stephen5ng/cube-pn5180/dev-boards/3C:8A:1F:77:E3:4D.jpg

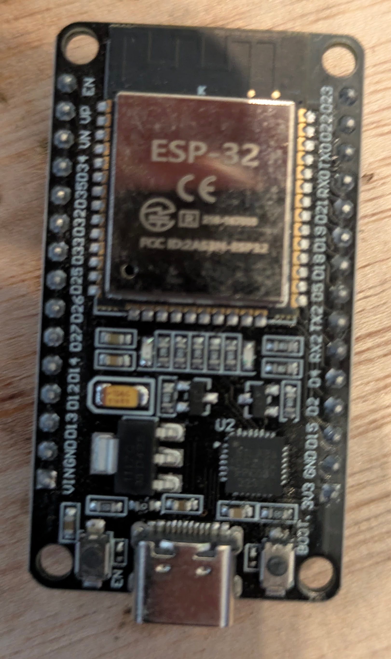
dev-boards/3C:8A:1F:77:E3:4D.jpg
