stephen5ng/cube-pn5180/dev-boards/ESP32_14-33-5C-30-29-EC_counterfeit.jpg

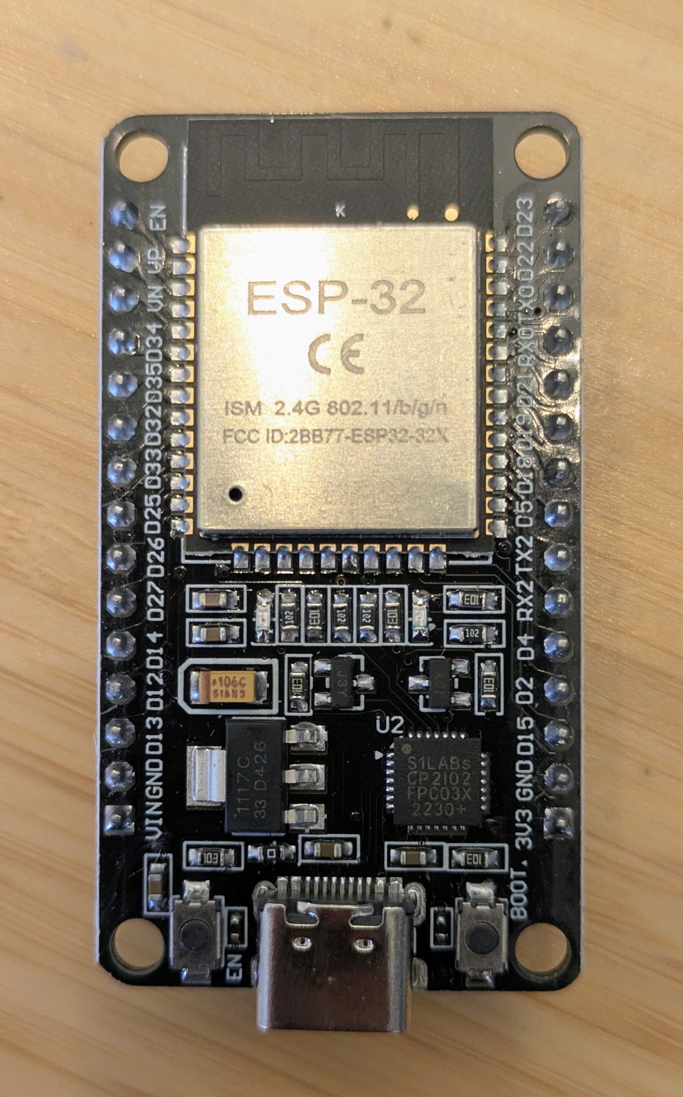
dev-boards/ESP32_14-33-5C-30-29-EC_counterfeit.jpg
