stephen5ng/cube-pn5180/docs/bad_esp32_chips.md

# Bad ESP32 Chips

Track ESP32 modules removed due to hardware defects.
MAC addresses from nearby batches may have similar issues.

| MAC | Was Cube | Issue | Date Removed |
|-----|---|---|---|
| 14:33:5C:30:25:98 | 5 | WiFi latency — persistent 500-3000ms MQTT delays, not fixed by power cycle or reboot | 2026-04-08 |
| 94:54:C5:EE:87:F0 | 5 | HUB75 display problems — severe display artifacts | 2026-04-08 |
