stephen5ng/cube-pn5180/(list of files, drawings)

Other design files:
hardware/v6/cube-esp32-c6-easyeda-sch.json
hardware/v6/cube-esp32-c6-easyeda.json
