stephen5ng/cube-pn5180/hardware/v6/kicad/cube-esp32-c6.kicad_pcb

## KiCad design hardware/v6/kicad/cube-esp32-c6.kicad_pcb (2026-03-04, last stored version)

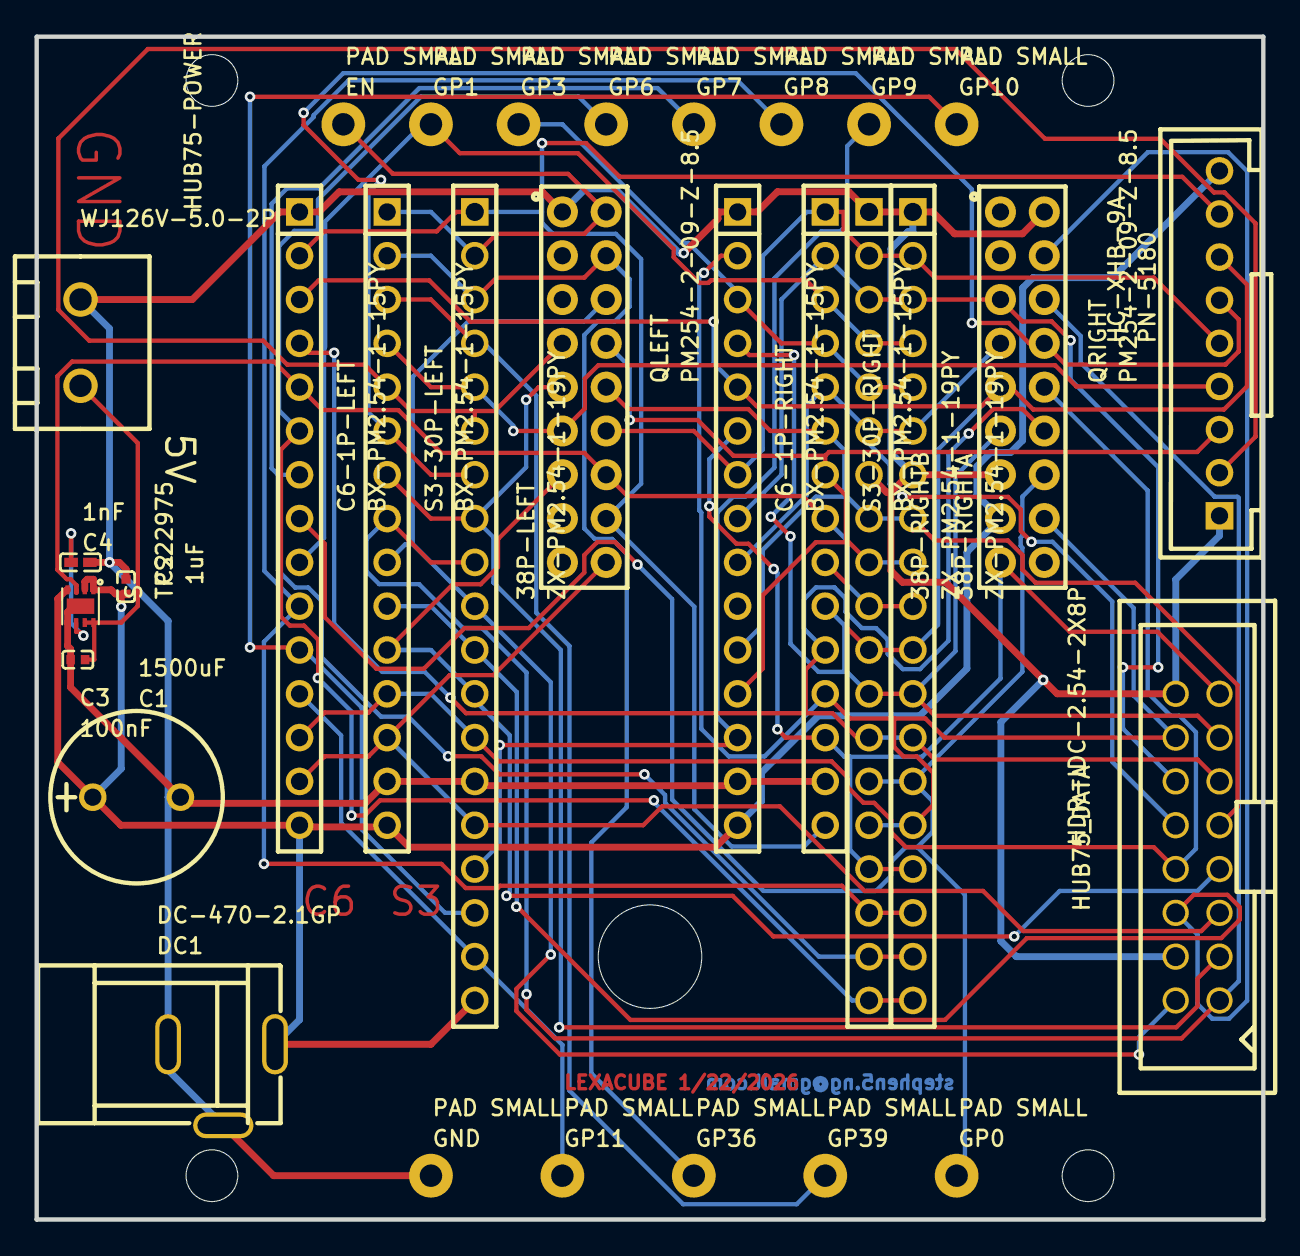
[picture p3: board cube-esp32-c6.kicad_pcb from above]

Board: 2 copper layers, 71.1 x 68.6 mm, 36 parts (0 on the bottom side), 38 nets.

Parts:
38P-LEFT, 38P-RIGHTA, 38P-RIGHTB: ZX-PM2.54-1-19PY; HDR-TH_19P-P2.54-V-F
C1: 1500uF; CAP-TH_BD10.0-P5.00-D1.0-FD
C2: 1uF; C0402
C3: 100nF; C0402
C4: 1nF; C0402
C6-1P-LEFT, C6-1P-RIGHT: BX-PM2.54-1-15PY; HDR-TH_15P-P2.54-V-F-1
DC1: DC-470-2.1GP; DC-IN-TH_DC-470-2.1GP
EN: PAD SMALL; PADPAD
GND: PAD SMALL; PADPAD
GP0, GP1, GP3, GP6, GP7, GP8, GP9, GP10, GP11, GP36, GP39: PAD SMALL; PADPAD
HUB75-POWER: WJ126V-5.0-2P; CONN-TH_WJ126V-5.0-2P
HUB75_DATA: HDR-IDC-2.54-2X8P; IDC-TH_16P-P2.54_C3406
Hole_gge5988: Hole_gge5988
Hole_gge6018: Hole_gge6018
Hole_gge6033: Hole_gge6033
Hole_gge6048: Hole_gge6048
Hole_gge95769: Hole_gge95769
PN-5180: HC-XHB-9A; CONN-TH_9P_P2.50_HCTL_HC-XHB-9A
QLEFT: PM254-2-09-Z-8.5; HDR-TH_18P-P2.54-V-F-R2-C9-S2.54
QRIGHT: PM254-2-09-Z-8.5; HDR-TH_18P-P2.54-V-F-R2-C9-S2.54
S: TPS22975; WSON-8_L2.0-W2.0-P0.50-TL-EP
S3-30P-LEFT, S3-30P-RIGHT: BX-PM2.54-1-15PY; HDR-TH_15P-P2.54-V-F-1

Connections:
3V: 38P-LEFT.1, C6-1P-LEFT.2, PN-5180.8, QLEFT.16, S3-30P-RIGHT.15
+5V: 38P-LEFT.19, C1.1, C2.2, C6-1P-LEFT.15, C6-1P-RIGHT.15, DC1.1, PN-5180.9, QRIGHT.15, S.1, S.2, S.4, S3-30P-LEFT.15
A: 38P-RIGHTA.8, 38P-RIGHTB.8, C6-1P-RIGHT.11, HUB75_DATA.9, QLEFT.10, S3-30P-RIGHT.6
B: 38P-RIGHTA.6, 38P-RIGHTB.6, C6-1P-RIGHT.9, HUB75_DATA.10, QRIGHT.7, S3-30P-RIGHT.5
B1: 38P-LEFT.8, HUB75_DATA.3, QLEFT.9, S3-30P-LEFT.7
B2: 38P-LEFT.12, HUB75_DATA.7, QLEFT.13, S3-30P-LEFT.11
BUSY: 38P-LEFT.6, PN-5180.2, QLEFT.7, S3-30P-LEFT.5
C: 38P-RIGHTA.13, 38P-RIGHTB.13, C6-1P-LEFT.4, HUB75_DATA.11, QRIGHT.12, S3-30P-RIGHT.11
CLK: 38P-RIGHTA.12, 38P-RIGHTB.12, C6-1P-RIGHT.4, HUB75_DATA.13, QRIGHT.11, S3-30P-RIGHT.10
D: 38P-RIGHTA.3, 38P-RIGHTB.3, C6-1P-RIGHT.8, HUB75_DATA.12, QRIGHT.5, S3-30P-RIGHT.2
E: 38P-LEFT.13, C6-1P-LEFT.13, HUB75_DATA.8, QRIGHT.10, S3-30P-LEFT.12
EN: 38P-LEFT.2, EN.1, QLEFT.2, S3-30P-LEFT.1
G1: 38P-LEFT.10, HUB75_DATA.2, QLEFT.6, S3-30P-LEFT.9
G2: 38P-LEFT.11, HUB75_DATA.6, QRIGHT.4, S3-30P-LEFT.10
GND: 38P-LEFT.14, 38P-RIGHTA.1, 38P-RIGHTA.7, 38P-RIGHTB.1, 38P-RIGHTB.7, C1.2, C2.1, C3.2, C4.2, C6-1P-LEFT.1, C6-1P-RIGHT.1, C6-1P-RIGHT.14, DC1.2, DC1.3, GND.1, HUB75-POWER.1, HUB75_DATA.4, HUB75_DATA.16, PN-5180.1, QLEFT.1, QRIGHT.2, QRIGHT.13, S.5, S.9, S3-30P-LEFT.14, S3-30P-RIGHT.14
GP_0: 38P-RIGHTA.14, 38P-RIGHTB.14, C6-1P-LEFT.8, GP0.1, QRIGHT.14
GP_1: 38P-RIGHTA.4, 38P-RIGHTB.4, C6-1P-LEFT.9, GP1.1, S3-30P-RIGHT.3
GP_3: 38P-RIGHTA.5, 38P-RIGHTB.5, C6-1P-RIGHT.3, GP3.1, S3-30P-RIGHT.4
GP_5: 38P-RIGHTA.10, 38P-RIGHTB.10, C6-1P-LEFT.5, QLEFT.14, S.3, S3-30P-RIGHT.8
GP_6: 38P-RIGHTA.19, 38P-RIGHTB.19, C6-1P-LEFT.6, GP6.1
GP_7: 38P-RIGHTA.18, 38P-RIGHTB.18, C6-1P-LEFT.7, GP7.1
GP_8: 38P-RIGHTA.17, 38P-RIGHTB.17, C6-1P-LEFT.10, GP8.1
GP_9: 38P-LEFT.16, C6-1P-RIGHT.13, GP9.1
GP_10: 38P-LEFT.17, C6-1P-LEFT.11, GP10.1
GP_11: 38P-LEFT.18, C6-1P-LEFT.12, GP11.1
GP_36: 38P-LEFT.3, GP36.1, QLEFT.4, S3-30P-LEFT.2
GP_39: 38P-LEFT.4, GP39.1, S3-30P-LEFT.3
LAT: 38P-RIGHTA.15, 38P-RIGHTB.15, C6-1P-RIGHT.2, HUB75_DATA.14, QRIGHT.16, S3-30P-RIGHT.12
MISO: 38P-LEFT.5, PN-5180.4, QLEFT.11, S3-30P-LEFT.4
MOSI: 38P-RIGHTA.2, 38P-RIGHTB.2, C6-1P-RIGHT.7, PN-5180.5, QLEFT.12, S3-30P-RIGHT.1
NSS: 38P-LEFT.7, PN-5180.6, QRIGHT.8, S3-30P-LEFT.6
OE: 38P-RIGHTA.16, 38P-RIGHTB.16, C6-1P-RIGHT.6, HUB75_DATA.15, QRIGHT.17, S3-30P-RIGHT.13
R1: 38P-LEFT.9, HUB75_DATA.1, QRIGHT.6, S3-30P-LEFT.8
R2: 38P-LEFT.15, C6-1P-LEFT.14, HUB75_DATA.5, QLEFT.18, S3-30P-LEFT.13
RST: 38P-RIGHTA.11, 38P-RIGHTB.11, C6-1P-LEFT.3, C6-1P-RIGHT.5, PN-5180.7, QRIGHT.9, S3-30P-RIGHT.9
SCK: 38P-RIGHTA.9, 38P-RIGHTB.9, C6-1P-RIGHT.12, PN-5180.3, QLEFT.8, S3-30P-RIGHT.7
S_6: C4.1, S.6
S_7: C3.1, HUB75-POWER.2, S.7, S.8
