stephen5ng/cube-pn5180/src/hall_presence.h

#pragma once

#include <math.h>
#include <stdint.h>

// Presence detection for the DRV5055 analog hall sensor. No Arduino dependencies, so it
// unit-tests natively.
//
// Compares against a tracked baseline rather than a fixed midpoint, because the sensor
// centre is ratiometric to +3V3 while the ESP32 ADC references its own bandgap: rail
// movement shows up directly as a reading shift and is the same order as the signal.
struct HallPresenceConfig {
  int8_t   direction;         // +1 if the presence magnet drives the reading up
  int16_t  on_delta;          // counts from baseline to assert
  int16_t  off_delta;         // counts to release
  uint8_t  fast_shift;        // IIR shift on the raw reading
  uint8_t  base_shift;        // IIR shift on the baseline
  uint16_t base_interval_ms;  // how often the baseline may adapt
};

// A baseline is only worth writing to flash when it was taken with nothing
// magnetic nearby, because an NVS seed outlives the mistake: a poisoned RTC
// value costs one wake, a poisoned seed costs every cold boot until something
// overwrites it. An id_mask of 0 is the physical proof -- no ID magnet is in
// range, so no neighbour is docked and its presence magnet cannot be skewing
// the reading, whether or not the tracker has asserted.
//
// The move threshold is what keeps this off the flash: the baseline wanders a
// count or two a second, and NVS erases a sector per write.
static constexpr int PRESENCE_BASELINE_SAVE_DELTA = 16;

inline bool shouldSavePresenceBaseline(uint8_t id_mask, bool active, int baseline,
                                       int stored) {
  if (id_mask != 0 || active) return false;
  const int move = baseline > stored ? baseline - stored : stored - baseline;
  return move > PRESENCE_BASELINE_SAVE_DELTA;
}

// delta is a field strength, which falls off as the cube of distance, so it is a
// badly misleading gauge of how close a neighbour is: the 176 -> 148 drop
// measured while re-seating slot 1 looks like losing a sixth of the signal and
// is under 6% of extra gap. These convert it to a distance, in units where 100
// is the gap at which presence latches on.
//
// Calibration-free by construction: only the ratio to on_delta matters, so no
// bench measurement of a real gap is needed. The cost is that the number is
// relative, not millimetres, and the inverse-cube law holds in the far field --
// across a gap comparable to the magnet the true exponent is smaller, so a
// distance change is somewhat larger than reported.
static constexpr int PRESENCE_DISTANCE_REFERENCE = 100;
static constexpr int PRESENCE_DISTANCE_OUT_OF_RANGE = 999;

inline int hallPresenceDistance(int delta, int on_delta) {
  if (delta < 1) return PRESENCE_DISTANCE_OUT_OF_RANGE;  // at or behind the baseline
  return (int)lroundf(PRESENCE_DISTANCE_REFERENCE *
                      cbrtf((float)on_delta / (float)delta));
}

// 0..100 for driving an animation: 0 is nothing in range, 100 is as close as a
// docked neighbour gets. Rising with proximity so brightness, size or speed can
// use it directly, and clamped at both ends so a consumer never has to know
// about the out-of-range sentinel.
//
// The endpoints are where the number stops being informative rather than where
// the thresholds sit, and both are stated in the delta counts they were
// measured in rather than in derived distance: the far end is the ADC noise
// floor, beyond which nothing is distinguishable from an idle sensor, and the
// near end is a docked reading. Presence latching and releasing both fall
// inside this span, which is deliberate -- most of the visible travel happens
// before a cube is close enough to latch.
// Measured on slot 1 on 2026-08-13, five weeks before v2.3 and its DRV5055A2
// existed -- so these, like every other delta in this file, are A4 numbers.
// (Slot 1 carries a v2.3 board now, which is the whole reason for the gain.)
// See hallGainForRev().
static constexpr int PRESENCE_CLOSENESS_NOISE_DELTA = 35;    // measured on slot 1
static constexpr int PRESENCE_CLOSENESS_DOCKED_DELTA = 127;  // measured on slot 1

// The hall board's presence sensor sets how many ADC counts a given field is
// worth, and the two revs in the fleet are not the same part:
//
//   v2.2        DRV5055A4   12.5 mV/mT   gain 1  (what every delta here is
//                                                 calibrated against)
//   v2.3, v2.4  DRV5055A2   50 mV/mT     gain 4
//
// The whole family is binary steps off A4 -- A3 25 mV/mT, A1 100 mV/mT -- so an
// integer gain covers every variant and no delta needs floating point. Both
// parts share the ratiometric VCC/2 quiescent output, so the gain changes how
// far a magnet moves the reading and not where the reading rests: the baseline
// tracker is unaffected, only the thresholds scale.
//
// Nothing can detect this at runtime. At rest the two are indistinguishable, so
// a cube has to be told; see cube/device/<mac>/hall_rev.
inline int hallGainForRev(const char* rev) {
  if (rev == nullptr) return 0;
  if (rev[0] != 'a' && rev[0] != 'A') return 0;
  if (rev[1] == '\0' || rev[2] != '\0') return 0;
  switch (rev[1]) {
    case '1': return 8;
    case '2': return 4;
    case '3': return 2;
    case '4': return 1;
    default:  return 0;   // unparseable; caller keeps its current gain
  }
}

// A gain that came back from NVS or off the wire. Anything else is corruption or
// a typo, and silently scaling the thresholds by it would be worse than
// ignoring it.
inline bool plausibleHallGain(int gain) {
  return gain == 1 || gain == 2 || gain == 4 || gain == 8;
}

// ID-magnet patterns, as measured off the physical carriers on 2026-10-25 with
// each cube read by its right-hand neighbour. The magnets sit in fixed slots in
// a printed carrier, so these patterns are a survey of the hardware, not a
// scheme the hardware was built to match -- which is why they look arbitrary.
//
// Bit i is sensor P(i+1); exactly two bits are ever valid. The decode is
// per-player because the two groups reuse patterns: player 0's cube 2 (P4+P6)
// is player 1's cube 14, and cube 3 (P3+P6) is cube 16. Cubes from different
// players never dock, so the same mask resolving to two ids is harmless -- but
// one shared table cannot express it (two `case` labels, one value), and a
// reader only ever needs the table for its own group.
inline uint8_t hallCubeIdForMaskPlayer0(uint8_t id_mask) {
  switch (id_mask & 0x3F) {
    case 0b000011: return 1;  // P1+P2
    case 0b101000: return 2;  // P4+P6
    case 0b100100: return 3;  // P3+P6
    case 0b011000: return 4;  // P4+P5
    case 0b001001: return 5;  // P1+P4
    case 0b000110: return 6;  // P2+P3
    default:       return 0;
  }
}

// Player 1, measured with the cubes ordered A through F.
inline uint8_t hallCubeIdForMaskPlayer1(uint8_t id_mask) {
  switch (id_mask & 0x3F) {
    case 0b110000: return 11;  // P5+P6
    case 0b100010: return 12;  // P2+P6
    case 0b001100: return 13;  // P3+P4
    case 0b101000: return 14;  // P4+P6
    case 0b000101: return 15;  // P1+P3
    case 0b100100: return 16;  // P3+P6
    default:       return 0;
  }
}

// Maps a 6-bit ID mask to a neighbour cube id; 0 = invalid pattern.
//
// `own_slot` is the READER's slot, which picks the table: player 0 is slots
// 1-6, player 1 is 11-16. An unresolved slot (-1) has no group and so decodes
// nothing -- a cube that does not know who it is cannot say who is beside it.
//
// No weight check: every pattern above has exactly two bits, so a mask of any
// other weight matches no case and falls through to 0 on its own. The call
// sites used to test popcount before calling, which read as a guard and was
// really a restatement of the table. A three-bit mask -- what a stray
// positioning magnet produces -- is rejected by not being in the table.
inline uint8_t hallCubeIdForMask(uint8_t id_mask, int own_slot) {
  if (own_slot >= 1 && own_slot <= 6) return hallCubeIdForMaskPlayer0(id_mask);
  if (own_slot >= 11 && own_slot <= 16) return hallCubeIdForMaskPlayer1(id_mask);
  return 0;
}

// Which side of a cube its hall board is mounted on. Player 0's boards face
// left, player 1's face right. That is a mechanical fact about the enclosures
// and it must not reach the game, so it is resolved here.
enum class HallSensorSide { None, Left, Right };

inline HallSensorSide hallSensorSideForSlot(int own_slot) {
  if (own_slot >= 1 && own_slot <= 6) return HallSensorSide::Left;
  if (own_slot >= 11 && own_slot <= 16) return HallSensorSide::Right;
  return HallSensorSide::None;
}

// What to publish on cube/right/<topic_slot>, whose payload asserts
// "<subject_slot> is immediately to the right of <topic_slot>". That is the
// server's convention: scripts/start_game.py publishes right/<A> = <B> for a
// word spelled A then B.
//
// A cube sensing on its RIGHT observes that relation directly and is its
// subject: right/<me> = <neighbour>. A cube sensing on its LEFT sees the mirror
// image -- the neighbour is to ITS left -- so the same physical edge keys on
// the NEIGHBOUR instead: right/<neighbour> = <me>. Publishing the sensor's
// point of view on the cube's own topic asserts the edge backwards, which
// reverses the whole row, and the row is the word.
//
// topic_slot 0 means there is nothing to assert. A left-side sensor with no
// neighbour is the case that matters: it has no subject and no topic of its
// own, so the caller retires whichever topic it last wrote.
struct HallEdgeAssertion {
  int topic_slot;
  int subject_slot;  // 0 publishes "-", the standing "no neighbour" value
};

inline HallEdgeAssertion hallEdgeAssertion(int own_slot, uint8_t neighbor_id) {
  switch (hallSensorSideForSlot(own_slot)) {
    case HallSensorSide::Right:
      return {own_slot, (int)neighbor_id};
    case HallSensorSide::Left:
      if (neighbor_id == 0) return {0, 0};
      return {(int)neighbor_id, own_slot};
    case HallSensorSide::None:
    default:
      return {0, 0};
  }
}

// What a cube owes the cube/right topics when it (re)connects. Every record
// there is retained, so a stale one outlives the cube that wrote it and the
// game applies it without consulting sensor_mode -- a ghost edge, and a ghost
// word around it.
//
// Who may clear what follows from who is the SUBJECT. A right-facing cube is
// the subject of its own topic and clears it. A left-facing cube is the subject
// of its NEIGHBOUR's topic: clearing its own would delete a live edge written
// by the cube to its right, which republishes only on change, so it must not
// touch it. What it can do is retire records that name IT, because it can be to
// the right of exactly one cube.
//
// The left-facing case does NOT depend on the sensor mode, and that is the
// whole point. A cube replugged with an NFC reader stops writing cube/right
// entirely, so its last hall-era assertion -- sitting on its old neighbour's
// topic -- is exactly the record nothing else will ever overwrite.
enum class HallEdgeCleanup {
  None,              // no slot or no group: nothing to assert, nothing to retire
  ClearOwnStanding,  // own subject, hall board fitted: the standing "no neighbour"
  ClearOwnRetire,    // own subject, no hall board: delete the record outright
  WatchSelfClaims,   // not own subject: retire records naming this cube
};

inline HallEdgeCleanup hallEdgeCleanupOnConnect(int own_slot,
                                                bool sensing_magnets) {
  switch (hallSensorSideForSlot(own_slot)) {
    case HallSensorSide::Right:
      return sensing_magnets ? HallEdgeCleanup::ClearOwnStanding
                             : HallEdgeCleanup::ClearOwnRetire;
    case HallSensorSide::Left:
      return HallEdgeCleanup::WatchSelfClaims;
    case HallSensorSide::None:
    default:
      return HallEdgeCleanup::None;
  }
}

// What a hall_rev message has to do, decided from the gain it names, the gain
// NVS holds (0 if nothing is stored) and the gain the firmware is running.
//
// The distinction that matters is Persist. A cube whose build default already
// equals the named gain needs no reboot, but it does need the write: the
// default is a property of the carrier the firmware was compiled for, not of
// the daughterboard someone plugged in, so leaving NVS empty means a reflash to
// a carrier with a different default silently reverts the board's real gain.
// Storing it is what makes the setting outlive the build.
enum class HallRevAction {
  Unparseable,      // not a rev name; keep the current gain
  AlreadyApplied,   // running and stored both agree; a retained message lands here
  Persist,          // running gain is right, NVS does not say so yet
  PersistAndApply,  // running gain is wrong: store it, then rebuild the copies
};

inline HallRevAction hallRevAction(const char* rev, int stored, int running) {
  const int gain = hallGainForRev(rev);
  if (gain == 0) return HallRevAction::Unparseable;
  if (gain != running) return HallRevAction::PersistAndApply;
  if (gain != stored) return HallRevAction::Persist;
  return HallRevAction::AlreadyApplied;
}

inline int hallPresenceCloseness(int delta, int on_delta, int gain = 1) {
  const int far = hallPresenceDistance(PRESENCE_CLOSENESS_NOISE_DELTA * gain, on_delta);
  const int near_by = hallPresenceDistance(PRESENCE_CLOSENESS_DOCKED_DELTA * gain, on_delta);
  const int distance = hallPresenceDistance(delta, on_delta);
  if (distance >= far) return 0;
  if (distance <= near_by) return 100;
  return 100 * (far - distance) / (far - near_by);
}

// Whether a decoded neighbour ID may be believed, given the ID already seated during
// this presence latch (0 if none yet).
//
// A cube offset against its neighbour shows the ID sensors a real, stable pattern that
// belongs to another cube: slid one column, cube 11's P5+P6 magnets sit over P4+P5,
// which is cube 4, and a one-row offset turns 14 into 15. At Maker Faire 2026-09, 94
// of 105 out-of-set IDs were exactly that "4". Presence does not stop it: the
// hysteresis that keeps a docked cube latched down to off_delta keeps it latched
// through the slide too.
//
// So a *change* to a different ID is only believed from a neighbour that reads docked,
// while everything else passes as before:
//  - no ID, so that "no neighbour" is never held back;
//  - the seated ID coming back after a dropout, so a loosely seated cube that
//    glitches is not stranded at "no neighbour" until someone pushes it in;
//  - the first ID of a latch, because latching already required on_delta.
// Swaps within one latch are rare: 5 direct ID-to-ID changes against 6709 re-links
// through "no neighbour" over the same weekend.
inline uint8_t gateHallNeighborChange(uint8_t id, uint8_t seated_id, int delta,
                                      int docked_delta) {
  if (id == 0 || seated_id == 0 || id == seated_id) return id;
  return delta >= docked_delta ? id : 0;
}

// The neighbour ID a hall cube settles on, one decoded sample at a time.
//
// A dock or undock is reported after debounce_reads identical samples. A change
// from the seated cube to a different one waits settle_reads instead, because
// the strength check reads the tracker's filtered delta, and that lags a slide by
// about 2^fast_shift samples: a cube slid off its neighbour still reads docked
// for the first few milliseconds, long enough for a plain debounce to report the
// alias. settle_reads has to span several of those time constants.
struct HallNeighborDebounce {
  HallNeighborDebounce(uint16_t debounce_reads, uint16_t settle_reads, int docked_delta)
      : debounce_reads(debounce_reads), settle_reads(settle_reads),
        docked_delta(docked_delta) {}

  uint16_t debounce_reads;
  uint16_t settle_reads;
  int docked_delta;
  uint8_t candidate = 0;
  uint16_t count = 0;
  uint8_t seated = 0;  // last ID reported during this presence latch

  // True once `candidate` has held long enough to be reported.
  bool update(uint8_t decoded, bool presence_active, int delta) {
    if (!presence_active) seated = 0;
    const uint8_t id = gateHallNeighborChange(decoded, seated, delta, docked_delta);
    if (id == candidate) {
      if (count < UINT16_MAX) count++;
    } else {
      candidate = id;
      count = 1;
    }
    const bool change = candidate != 0 && seated != 0 && candidate != seated;
    return count >= (change ? settle_reads : debounce_reads);
  }

  // Call once `candidate` has actually been reported.
  void reported() {
    if (candidate != 0) seated = candidate;
  }
};

// The shared-edge animation is an approach hint, not a second representation of
// a confirmed neighbour. A real dock can settle below the calibrated 100% point,
// so the presence latch, rather than closeness alone, ends the preview.
inline bool shouldPreviewHallCandidate(int proximity, bool presence_active) {
  return !presence_active && proximity > 0 && proximity < 100;
}

// Where each participant's prospective neighbour sits, for the border preview.
//
// The payload is a FACT about the topology -- "my neighbour is on my west/east"
// -- not an instruction about which side to draw. That distinction is the whole
// bug history of this protocol: the preview renders two different shapes from
// it, on OPPOSITE sides, so no single "draw here" value can serve both.
//
//   free endpoint      drawEndPath caps the end AWAY from the neighbour
//   already in a chain drawPreviewSideErasing animates the shared edge,
//                      which is ON the neighbour's side
//
// previewDrawsLeftSide() turns this fact into the side to draw. Sending a side
// directly got the free-end case right and the in-chain case backwards, or the
// reverse, depending on which way round it was sent.
//
// Which side the neighbour is on follows from where the board faces: a cube
// sensing leftward has found it on its left, and is itself on its neighbour's
// right. Same mechanical fact hallEdgeAssertion resolves.
struct HallPreviewNeighbourSides {
  const char* mine;       // "" when this cube has no group and must not publish
  const char* candidate;
};

inline HallPreviewNeighbourSides hallPreviewNeighbourSides(int own_slot) {
  switch (hallSensorSideForSlot(own_slot)) {
    // I sense leftward: my neighbour is west of me, and I am east of it.
    case HallSensorSide::Left:   return {"W", "E"};
    case HallSensorSide::Right:  return {"E", "W"};
    case HallSensorSide::None:
    default:                     return {"", ""};
  }
}

// Which side the preview draws on, given where the neighbour is and whether
// this cube already has a settled vertical edge. The two topologies want
// opposite sides, which is why this is a function rather than the payload.
inline bool previewDrawsLeftSide(bool neighbour_on_left, bool has_confirmed_edge) {
  return has_confirmed_edge ? neighbour_on_left   // the shared edge, on its side
                            : !neighbour_on_left; // the free end, away from it
}

class HallPresenceTracker {
 public:
  // saved_baseline carries a baseline across a wake. Priming from the first sample
  // is blind to a magnet that is already there: the magnet gets subtracted into the
  // baseline and the neighbour is never seen. 0 means nothing was saved -- a cold
  // boot re-initialises RTC memory -- and the first sample primes as before.
  void begin(const HallPresenceConfig& cfg, int saved_baseline = 0) {
    cfg_ = cfg;
    primed_ = false;
    settle_started_ = false;
    active_ = false;
    delta_ = 0;
    base_primed_ = saved_baseline > 0;
    // Set either way. Leaving the old value in place would let baseline() keep
    // reporting a reference that begin() has just discarded, and anything that
    // copies it out -- the RTC cache, the diagnostics -- would carry it forward.
    base_ = (int32_t)(base_primed_ ? saved_baseline : 0) << cfg_.base_shift;
  }

  // id_mask is what the ID sensors read: non-zero means a neighbour is physically
  // there. Those sensors are digital and independent of this reading, so they can
  // say so while the analog signal is still below the trip point -- which is the
  // whole range the baseline must not adapt through.
  bool update(int raw, uint32_t now_ms, uint8_t id_mask) {
    if (!primed_) {
      fast_ = (int32_t)raw << cfg_.fast_shift;
      last_base_ms_ = now_ms;
      primed_ = true;
    } else {
      fast_ += raw - (fast_ >> cfg_.fast_shift);
    }

    const int f = (int)(fast_ >> cfg_.fast_shift);

    // Priming from a sample taken with a neighbour present subtracts the magnet
    // into the baseline and it is never seen again. Cubes are powered up in
    // whatever arrangement they were left in, so that is a coin flip on every
    // cold boot; wait for a clean sample instead. Until one arrives there is no
    // reference, and nothing can be reported from it.
    if (!base_primed_) {
      if (id_mask != 0) {
        settle_started_ = false;
        delta_ = 0;
        active_ = false;
        return false;
      }
      // A cold boot reaches here before the sensor output has settled. Slot 16
      // primed from a first sample of 1702 against a true idle near 1850, latched
      // on the difference, and had persisted the bad value to NVS before the
      // activation closed the save gate -- so a power cycle restored it.
      if (!settle_started_) {
        settle_started_ = true;
        settle_start_ms_ = now_ms;
        // The fast filter carries whatever it tracked through the blind period,
        // which may include a magnet that has since gone.
        fast_ = (int32_t)raw << cfg_.fast_shift;
      }
      if ((uint32_t)(now_ms - settle_start_ms_) < PRIME_SETTLE_MS) {
        delta_ = 0;
        active_ = false;
        return false;
      }
      // From the filtered value rather than this one sample: it has tracked only
      // magnet-free samples since settling began, so it is the same reading with
      // the noise taken out.
      base_ = (int32_t)f << cfg_.base_shift;
      base_primed_ = true;
      last_base_ms_ = now_ms;
      delta_ = 0;
      active_ = false;
      return false;
    }

    delta_ = cfg_.direction * (f - baseline());

    if (!active_) {
      if (delta_ >= cfg_.on_delta) active_ = true;
    } else {
      if (delta_ < cfg_.off_delta) active_ = false;
    }

    // Frozen while a neighbour is there, latched or not: otherwise the baseline
    // creeps up to the magnet and the cube forgets the neighbour is there.
    //
    // Frozen through a wrong-pole excursion too. active_ only latches upwards,
    // so a magnet presented the wrong way round leaves it false and the
    // baseline used to adapt down through the excursion. When the magnet left,
    // the restored idle reading stood on_delta clear of that poisoned
    // reference and latched with no neighbour there -- seen on cube 13, which
    // walked 1893 -> 1793 under a hand-waved magnet and then sat active at
    // delta +99, and on cube 1 after a bench flash. Anything at latch strength
    // is signal in either direction; only drift-sized moves are drift.
    // Tested on the raw sample as well as the filtered one. The fast filter
    // lags a step by design, so going by delta_ alone lets the baseline take a
    // nibble out of the excursion while the reading is still crossing the
    // drift-sized band on its way down. The raw value is the evidence; at
    // on_delta against +/-13 counts of ADC noise, one sample is enough.
    const bool excursion = delta_ <= -cfg_.on_delta ||
                           cfg_.direction * (raw - baseline()) <= -cfg_.on_delta;
    if (id_mask == 0 && !active_ && !excursion &&
        (uint32_t)(now_ms - last_base_ms_) >= cfg_.base_interval_ms) {
      base_ += f - (base_ >> cfg_.base_shift);
      last_base_ms_ = now_ms;
    }
    return active_;
  }

  bool active()   const { return active_; }
  // False until a sample arrived with no neighbour to prime from. While it is
  // false nothing is reported, which from outside looks the same as an absent
  // neighbour -- the diagnostics publish it so the two can be told apart.
  bool primed()   const { return base_primed_; }
  int  baseline() const { return (int)(base_ >> cfg_.base_shift); }
  int  filtered() const { return (int)(fast_ >> cfg_.fast_shift); }
  int  delta()    const { return delta_; }  // signed by direction; proximity measure
  // The latch threshold this tracker is actually running, which is a copy taken
  // in begin(). Reported in the diagnostics rather than recomputing it from the
  // configured gain: if the two ever disagree, the bug is exactly that the
  // tracker was not rebuilt, and a diagnostic that recomputed would hide it.
  int  onDelta()  const { return cfg_.on_delta; }

 private:
  HallPresenceConfig cfg_ {};
  int32_t  fast_ = 0;
  int32_t  base_ = 0;
  uint32_t last_base_ms_ = 0;
  int      delta_ = 0;
  bool     active_ = false;
  // How long the reading must be magnet-free before it is taken as the reference.
  static const uint32_t PRIME_SETTLE_MS = 500;
  bool     settle_started_ = false;
  uint32_t settle_start_ms_ = 0;
  bool     primed_ = false;
  bool     base_primed_ = false;
};
