stephen5ng/cube-pn5180/src/genfont.h

// Created by https://oleddisplay.squix.ch/ Consider a donation
// In case of problems make sure that you are using the font file with the correct version!
const uint8_t Roboto_Mono_Bold_78Bitmaps[] PROGMEM = {

	// Bitmap Data:
	0x00, // ' '
	0x7F,0xF3,0xFF,0x9F,0xFC,0xFF,0xE7,0xFF,0x3F,0xF9,0xFF,0xCF,0xFC,0x7F,0xE3,0xFF,0x1F,0xF8,0xFF,0xC7,0xFE,0x3F,0xF1,0xFF,0x8F,0xFC,0x7F,0xE3,0xFF,0x1F,0xF8,0xFF,0xC7,0xFE,0x3F,0xF1,0xFF,0x8F,0xFC,0x7F,0xE3,0xFF,0x1F,0xF8,0xFF,0xC7,0xFE,0x3F,0xF1,0xFF,0x8F,0xFC,0x7F,0xE3,0xFF,0x1F,0xF8,0xFF,0xC0,0x00,0x00,0x00,0x00,0x00,0x00,0x00,0x00,0x00,0x00,0x00,0x00,0x01,0xF8,0x1F,0xE1,0xFF,0x9F,0xFE,0xFF,0xF7,0xFF,0xBF,0xFD,0xFF,0xEF,0xFF,0x3F,0xF0,0xFF,0x03,0xF0, // '!'
	0xFF,0x01,0xFE,0xFF,0x01,0xFE,0xFF,0x01,0xFE,0xFF,0x01,0xFE,0xFF,0x01,0xFE,0xFE,0x01,0xFE,0xFE,0x01,0xFE,0xFE,0x01,0xFE,0xFE,0x01,0xFE,0xFE,0x01,0xFE,0xFE,0x01,0xFE,0xFE,0x01,0xFE,0xFE,0x01,0xFE,0xFE,0x01,0xFE,0xFE,0x01,0xFE,0xFE,0x01,0xFC,0xFE,0x01,0xFC,0xFE,0x01,0xFC,0xFE,0x01,0xFC,0xFC,0x01,0xFC, // '"'
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
	  {  7715,  38,  55,  48,    6,  -55 }, // 'E'
	  {  7977,  38,  55,  48,    6,  -55 }, // 'F'
	  {  8239,  41,  57,  48,    3,  -56 }, // 'G'
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
};
const GFXfont Roboto_Mono_Bold_78 PROGMEM = {
(uint8_t  *)Roboto_Mono_Bold_78Bitmaps,(GFXglyph *)Roboto_Mono_Bold_78Glyphs,0x20, 0x7E, 92};
