stephen5ng/cube-pn5180/src/cube_utilities.cpp

#include "cube_utilities.h"
#include <ctype.h>
#include <stdlib.h>

#ifdef NATIVE_TESTING
// Test MAC table - stable values that never change
// Hardware replacements should NOT require test updates
const CubeMacEntry CUBE_MAC_TABLE[] = {
  {"AA:AA:AA:AA:AA:AA", RGB_ORDER_BGR, 21},
  {"BB:BB:BB:BB:BB:BB", RGB_ORDER_BGR, 22},
  {"CC:CC:CC:CC:CC:CC", RGB_ORDER_BGR, 23},
  {"DD:DD:DD:DD:DD:DD", RGB_ORDER_BGR, 24},
  {"EE:EE:EE:EE:EE:EE", RGB_ORDER_BGR, 25},
  {"FF:FF:FF:FF:FF:FF", RGB_ORDER_BGR, 26},
  {"01:01:01:01:01:01", RGB_ORDER_RGB, 31},
  {"02:02:02:02:02:02", RGB_ORDER_RGB, 32},
  {"03:03:03:03:03:03", RGB_ORDER_RGB, 33},
  {"04:04:04:04:04:04", RGB_ORDER_RGB, 34},
  {"05:05:05:05:05:05", RGB_ORDER_RGB, 35},
  {"06:06:06:06:06:06", RGB_ORDER_RGB, 36},
  {"A1:A1:A1:A1:A1:A1", RGB_ORDER_RGB, 41},
};
#else
// Production MAC addresses - actual hardware
const CubeMacEntry CUBE_MAC_TABLE[] = {
  {"CC:DB:A7:9F:C2:84", RGB_ORDER_BGR, 21},  // 30-pin
  {"3C:8A:1F:77:DF:8C", RGB_ORDER_BGR, 22},  // 30-pin
  {"8C:4F:00:37:7C:DC", RGB_ORDER_BGR, 23},  // 30-pin
  {"CC:DB:A7:9B:5D:9C", RGB_ORDER_BGR, 24},  // 30-pin (moved from cube 11)
  {"04:83:08:59:76:98", RGB_ORDER_BGR, 25},
  {"EC:E3:34:79:8A:BC", RGB_ORDER_BGR, 26},  // 30-pin
  {"EC:E3:34:79:9D:2C", RGB_ORDER_RGB, 31},
  {"20:50:0D:1A:04:AC", RGB_ORDER_RGB, 32},  // 30-pin
  {"20:50:0D:30:95:48", RGB_ORDER_RGB, 33},
  {"94:54:C5:EE:89:4C", RGB_ORDER_RGB, 34},  // 30-pin
  {"20:50:0D:19:FB:C8", RGB_ORDER_RGB, 35},
  {"D8:BC:38:F9:39:30", RGB_ORDER_RGB, 36},  // 30-pin
  {"80:F3:DA:54:53:B8", RGB_ORDER_BGR, 41},
  {"B4:BF:E9:60:C0:68", RGB_ORDER_RGB, 42},
  {"5C:01:3B:64:E2:84", RGB_ORDER_RGB, 43},  // spare
  {"D4:8A:FC:9F:B0:C0", RGB_ORDER_BGR, 44},
  {"D8:BC:38:E5:A8:38", RGB_ORDER_RGB, 45},
  {"5C:01:3B:4A:87:4C", RGB_ORDER_RGB, 46},
  {"8C:4F:00:36:7A:88", RGB_ORDER_BGR, 47},  // spare
  {"5C:01:3B:65:F2:74", RGB_ORDER_RGB, 48},
  {"20:50:0D:0A:9F:A8", RGB_ORDER_RGB, 49},  // spare
};
#endif
const int NUM_CUBE_MAC_ENTRIES = sizeof(CUBE_MAC_TABLE) / sizeof(CUBE_MAC_TABLE[0]);

// MQTT Topic Prefixes
const char* MQTT_TOPIC_PREFIX_CUBE = "cube/";
const char* MQTT_TOPIC_PREFIX_ECHO = "echo";
const char* MQTT_TOPIC_PREFIX_VERSION = "version";

const CubeMacEntry* findCubeEntry(const char *mac_address) {
  for (int i = 0; i < NUM_CUBE_MAC_ENTRIES; i++) {
    if (strcmp(mac_address, CUBE_MAC_TABLE[i].mac) == 0) {
      return &CUBE_MAC_TABLE[i];
    }
  }
  return nullptr;
}

int findCubeIpOctet(const char *mac_address) {
  const CubeMacEntry* entry = findCubeEntry(mac_address);
  return entry ? entry->ip_octet : -1;
}

static const char* findJsonValue(const char* json, const char* key) {
  char pattern[24];
  snprintf(pattern, sizeof(pattern), "\"%s\"", key);
  const char* found = strstr(json, pattern);
  if (found == nullptr) {
    return nullptr;
  }
  const char* colon = strchr(found + strlen(pattern), ':');
  if (colon == nullptr) {
    return nullptr;
  }
  const char* value = colon + 1;
  while (isspace(static_cast<unsigned char>(*value))) {
    ++value;
  }
  return value;
}

static bool readJsonInt(const char* json, const char* key, long* out) {
  const char* value = findJsonValue(json, key);
  if (value == nullptr || *value < '0' || *value > '9') {
    return false;
  }
  char* end = nullptr;
  *out = strtol(value, &end, 10);
  while (isspace(static_cast<unsigned char>(*end))) {
    ++end;
  }
  return *end == ',' || *end == '}';
}

AssignmentParseResult parseAssignmentRecord(const char* json, CubeAssignment* out) {
  out->generation = 0;
  out->slot = -1;

  if (json == nullptr || json[0] == '\0') {
    return ASSIGNMENT_MISSING;
  }

  long protocol = 0;
  if (!readJsonInt(json, "protocol", &protocol) || protocol != 1) {
    return ASSIGNMENT_MALFORMED;
  }

  long generation = 0;
  if (!readJsonInt(json, "generation", &generation)) {
    return ASSIGNMENT_MALFORMED;
  }
  out->generation = static_cast<uint32_t>(generation);

  const char* slot_value = findJsonValue(json, "slot");
  if (slot_value == nullptr) {
    return ASSIGNMENT_MALFORMED;
  }
  if (strncmp(slot_value, "null", 4) == 0 &&
      (slot_value[4] == ',' || slot_value[4] == '}' ||
       isspace(static_cast<unsigned char>(slot_value[4])))) {
    return ASSIGNMENT_UNASSIGNED;
  }

  long slot = 0;
  if (!readJsonInt(json, "slot", &slot) || slot < 1 || slot > 16) {
    return ASSIGNMENT_MALFORMED;
  }
  out->slot = static_cast<int>(slot);
  return ASSIGNMENT_OK;
}

bool assignmentRecordIsActionable(AssignmentParseResult result) {
  return result == ASSIGNMENT_OK || result == ASSIGNMENT_UNASSIGNED;
}

int resolveAssignedSlot(AssignmentParseResult result, int record_slot,
                        bool authority_latched, int fallback_slot) {
  switch (result) {
    case ASSIGNMENT_OK:
      return record_slot;
    case ASSIGNMENT_UNASSIGNED:
      return -1;
    default:
      return authority_latched ? -1 : fallback_slot;
  }
}

void formatBootIdentity(char* out, size_t out_size, int slot, int ip_octet) {
  if (slot > 0) {
    snprintf(out, out_size, "c%d ip%d", slot, ip_octet);
  } else {
    snprintf(out, out_size, "c? ip%d", ip_octet);
  }
}

WakeAction resolveWakeAction(bool wifi_connected, bool mqtt_connected,
                             bool device_requests_sleep) {
  if (!wifi_connected || !mqtt_connected) return WAKE_ACTION_STAY_ASLEEP;
  return device_requests_sleep ? WAKE_ACTION_STAY_ASLEEP : WAKE_ACTION_WAKE_FULL;
}

void runWakeCheckIn(WakeReason wake_reason, WakeCheckInPorts& ports) {
  // Someone deciding to use the cube: the button, or a cold boot, which on the
  // battery board is unplugging USB-C -- the morning routine, and the way a
  // cube backed off for hours (checkInIntervalS) is brought back. A jostled
  // battery contact also cold-boots, and costs one ten-minute awake spell.
  if (wake_reason == WAKE_REASON_BUTTON || wake_reason == WAKE_REASON_POWER_ON) {
    ports.stayAwake();
    return;
  }

  // Any other reset -- brownout, watchdog, crash -- reads the sleep flag just
  // as a timer wake does. It is not someone deciding to use the cube, so a
  // stored cube that glitches goes back to sleep instead of burning ten
  // minutes of battery and making the next glitch likelier.
  const bool is_reset = (wake_reason == WAKE_REASON_OTHER);

  bool wifi = ports.awaitWifi();
  bool mqtt = wifi && ports.connectMqtt();
  ports.recordReachable(mqtt);
  if (!mqtt) {
    // The two wakes disagree about what silence means. A timer wake was
    // already asleep, so leaving it there costs nothing. A reset has no such
    // prior: sleeping because the broker happened to be unreachable would make
    // a working cube look dead to whoever is standing at the cabinet.
    if (is_reset) ports.stayAwake(); else ports.enterSleep();
    return;
  }

  bool sleep_requested = false;
  if (!ports.readSleepFlag(&sleep_requested)) {
    // Unconfirmed is not "no flag". Treating it as one is how a cube that
    // merely had a slow link cleared its own sleep flag and stayed awake for
    // ten minutes -- and a weak battery, which causes the slow link, is
    // exactly the cube that can least afford it.
    if (is_reset) ports.stayAwake(); else ports.enterSleep();
    return;
  }
  WakeAction action = resolveWakeAction(wifi, mqtt, sleep_requested);
  if (action == WAKE_ACTION_STAY_ASLEEP) { ports.enterSleep(); return; }
  ports.clearSleepFlag();
  ports.stayAwake();
}

uint32_t checkInIntervalS(uint32_t idle_s, uint32_t base_s,
                          uint8_t unreachable_checkins, uint32_t give_up_s) {
  if (idle_s >= give_up_s) return 0;
  if (base_s >= give_up_s) return base_s;
  uint32_t interval_s = base_s;
  for (uint8_t i = 0; i < unreachable_checkins && interval_s < give_up_s; i++) {
    interval_s *= 2;
  }
  // Never sleep past the point of giving up. A doubled interval can be shorter
  // than give_up_s and still land beyond it once idle_s is added, which would
  // have a cube on its ninth failed check-in wake at 2 h 50 min to apply a
  // 90 min rule.
  const uint32_t remaining_s = give_up_s - idle_s;
  return interval_s < remaining_s ? interval_s : remaining_s;
}

bool batteryLowEndsWake(WakeReason wake_reason, bool battery_low) {
  if (!battery_low) return false;
  return wake_reason == WAKE_REASON_TIMER || wake_reason == WAKE_REASON_OTHER;
}

bool updateBatteryLowLatch(uint32_t cell_mv, bool latched, uint8_t* low_run,
                           BatteryReading reading) {
  if (cell_mv < BATTERY_SENSE_FLOOR_MV) return latched;
  if (latched) {
    if (reading == BATTERY_READING_UNLOADED) return true;
    if (cell_mv < BATTERY_LOW_CLEAR_MV) return true;
    *low_run = 0;
    return false;
  }
  if (cell_mv >= BATTERY_LOW_MV) {
    *low_run = 0;
    return false;
  }
  if (*low_run < BATTERY_LOW_CONFIRM_READS) (*low_run)++;
  return *low_run >= BATTERY_LOW_CONFIRM_READS;
}

void convertNfcIdToHexString(uint8_t* nfc_id, int id_length, char* hex_buffer) {
  for (int i = 0; i < id_length; i++) {
    snprintf(hex_buffer + (i * 2), 3, "%02X", nfc_id[i]);
  }
  hex_buffer[id_length * 2] = '\0';
}

NfcObservationAction decideNfcObservation(bool read_ok, bool no_card,
                                          const char* tag_hex,
                                          const char* last_published) {
  if (read_ok) {
    if (tag_hex == nullptr) {
      return NFC_OBS_NONE;
    }
    return strcmp(tag_hex, last_published) == 0 ? NFC_OBS_NONE : NFC_OBS_TAG;
  }
  if (no_card) {
    return strcmp(last_published, "-") == 0 ? NFC_OBS_NONE : NFC_OBS_ABSENT;
  }
  return NFC_OBS_NONE;
}

NfcChatterResult applyNfcChatterGate(const NfcChatterState& state,
                                     NfcObservationAction action,
                                     bool read_ok, const char* tag_hex,
                                     unsigned long now_ms) {
  NfcChatterResult result;
  result.state = state;

  if (action == NFC_OBS_ABSENT) {
    // Disconnects are never held back -- apart is always the safe default.
    // Not counted as a flip itself: flip history only tracks CONNECTS, so
    // that a tag needs a second RECONNECT (not merely its first departure)
    // before it counts as chattering. `state.tag` already names the
    // departing candidate; nothing else changes here.
    result.state.connected = false;
    result.state.confirm_since_ms = 0;
    result.action = NFC_OBS_ABSENT;
    return result;
  }

  if (action == NFC_OBS_TAG) {
    bool same_tag_as_last_flip = strcmp(state.tag, tag_hex) == 0;

    if (same_tag_as_last_flip && state.connected) {
      // A forced re-announce (`cube/resend`, or any MQTT (re)connect --
      // main.cpp clears `last_observation_published` on both), not a real
      // arrival: nothing physically changed, so this must not count as a
      // flip. Republish as asked, untouched otherwise.
      result.action = NFC_OBS_TAG;
      return result;
    }

    // `flip_ms_older` is only set once this tag has connected at least
    // twice, so chattering can only trigger from the SECOND reconnect
    // onward -- the first departure-and-return of any tag is always instant.
    bool chattering = same_tag_as_last_flip && state.flip_ms_older != 0 &&
        (now_ms - state.flip_ms_older) <= NFC_CHATTER_WINDOW_MS;

    if (!chattering) {
      // A new tag, or this tag's first reconnect in a while: always
      // instant. Record this connect so a SECOND one soon after is what
      // triggers the gate, not this one.
      result.state.flip_ms_older = same_tag_as_last_flip ? state.flip_ms_newest : 0;
      result.state.flip_ms_newest = now_ms;
      strncpy(result.state.tag, tag_hex, sizeof(result.state.tag) - 1);
      result.state.tag[sizeof(result.state.tag) - 1] = '\0';
      result.state.connected = true;
      result.state.confirm_since_ms = 0;
      result.action = NFC_OBS_TAG;
      return result;
    }

    // Chattering: hold until this exact tag has read steadily for
    // NFC_CHATTER_CONFIRM_MS before accepting the reconnect.
    unsigned long confirm_since = state.confirm_since_ms != 0 ? state.confirm_since_ms : now_ms;
    if (now_ms - confirm_since >= NFC_CHATTER_CONFIRM_MS) {
      result.state.flip_ms_older = state.flip_ms_newest;
      result.state.flip_ms_newest = now_ms;
      result.state.connected = true;
      result.state.confirm_since_ms = 0;
      result.action = NFC_OBS_TAG;
    } else {
      result.state.confirm_since_ms = confirm_since;
      result.action = NFC_OBS_NONE;
    }
    return result;
  }

  // NFC_OBS_NONE. A confirmation in progress survives only if this read is
  // still the tag it is confirming -- anything else breaks the streak.
  if (state.confirm_since_ms != 0 &&
      !(read_ok && strcmp(state.tag, tag_hex) == 0)) {
    result.state.confirm_since_ms = 0;
  }
  result.action = NFC_OBS_NONE;
  return result;
}

void buildObservationPayload(const char* boot_id, const char* tag,
                             char* out, size_t out_size) {
  // protocol, boot_id, tag. Nothing else: the server validates no provenance,
  // so a field carried here would be complexity with no behaviour.
  snprintf(out, out_size, "{\"protocol\":1,\"boot_id\":\"%s\",\"tag\":\"%s\"}",
           boot_id, tag);
}

#ifdef NATIVE_TESTING
// C versions for native testing
void removeColonsFromMacC(const char* mac_address, char* output, size_t output_size) {
  size_t j = 0;
  for (size_t i = 0; mac_address[i] != '\0' && j < output_size - 1; i++) {
    if (mac_address[i] != ':') {
      output[j++] = mac_address[i];
    }
  }
  output[j] = '\0';
}

void createMqttTopicC(const char* cube_identifier, const char* suffix, char* output, size_t output_size) {
  snprintf(output, output_size, "%s%s/%s", MQTT_TOPIC_PREFIX_CUBE, cube_identifier, suffix);
}

void makeMqttClientIdC(const char* mac_address, const char* suffix, char* output, size_t output_size) {
  char nocolons[32];
  removeColonsFromMacC(mac_address, nocolons, sizeof(nocolons));
  snprintf(output, output_size, "cube-%s%s", nocolons, suffix);
}
#else
// Arduino String versions for ESP32
String removeColonsFromMac(const String& mac_address) {
  String result;
  result.reserve(mac_address.length());
  for (size_t i = 0; i < mac_address.length(); i++) {
    char c = mac_address[i];
    if (c != ':') {
      result += c;
    }
  }
  return result;
}

String createMqttTopic(const String& cube_identifier, const char* suffix) {
  String topic = MQTT_TOPIC_PREFIX_CUBE;
  topic += cube_identifier;
  topic += '/';
  topic += suffix;
  return topic;
}

String makeMqttClientId(const String& mac_address, const char* suffix) {
  return "cube-" + removeColonsFromMac(mac_address) + suffix;
}
#endif
