stephen5ng/cube-pn5180/(commit log)

2024-02-14 Wifi, HUB75, and NFC running on a single ESP32. Removed support for oled display--the hub75 is using the i2c pin so oled screws it up.
2024-02-28 Fix include problem. Center letter.
    [main.cpp]
2024-03-19 v16: much cleanup assuming bug is fixed. Add (no)debug tags.
    [main.cpp]
2024-03-21 Highlight correct letters for 2s.
    [main.cpp]
2024-03-21 Turn off caching of last letter to simplify code--there isn't a flicker problem so the cache probably doesn't do anything.
    [main.cpp]
2025-03-26 Reset NFC on every loop. Improve string handling: Use snprintf instead of String concatenation for better memory efficiency
    [main.cpp]
2025-03-27 don't reset if front panel, turn off debug messages
    [main.cpp]
2025-03-28 debug print
2025-04-01 Revert "Convert constants to constexpr for compile-time evaluation"
    This reverts commit 565ba6e276a63eb7eae1686d098ecab2938412fc.
    Screws up painting
    [main.cpp]
2025-04-02 update MAC, fix MQTT refactoring bugs
    [main.cpp]
2025-04-02 fix border in string mode
    [main.cpp]
2025-04-03 Move letter_animation into DisplayManager class and fix animation logic
    [main.cpp]
2025-04-05 update previous letter it it's too fast
    [main.cpp]
2025-05-05 unSCruz 2025
    [publish_client.diff.txt]
2025-06-07 swap OE and LAT, support mini
    [main.cpp]
2025-06-07 add udp ping, fix horizontal lines
    [main.cpp]
2025-06-23 border and id fixes
    [main.cpp]
2025-07-02 add vline support. remove old border character support. add small screen ordering. fix image init bug.
    [main.cpp]
2025-08-09 Add native testing framework for ESP32 Arduino code
    - Set up PlatformIO native environment with Unity test framework
    - Add convenience script ./test.sh for running tests
    - Include sample tests demonstrating basic functionality
    - Ready for adding actual ESP32 code tests in future commits
2025-08-09 Extract utility functions and add comprehensive tests
    - Extract MAC address lookup and NFC conversion functions to cube_utilities.h/.cpp
    - Remove code duplication from main.cpp
    - Add 9 comprehensive tests covering all utility functions
    - Test MAC address lookup, NFC ID conversion, and cube configuration logic
    - Include integration test for complete MAC-to-configuration workflow
    - All tests passing on native platform
    - ESP32 compilation confirmed working
2025-08-11 Fix VSCode build configuration and native environment setup
    - Configure platformio.ini to build only ESP32 by default (default_envs = esp32dev)
    - Add native environment configuration with proper source filtering and include paths
    - Create test/unity_config.h for Unity testing framework compatibility
    - Set VSCode default environment to esp32dev to prevent native build failures
    - Native tests remain available via 'platformio test -e native' command
    - All 9 native tests now pass successfully
2025-08-12 Add software sleep mode and improve NFC reliability
    - Implement software sleep mode with MQTT command '/cube/sleep'
    - Add timer-based wake-up for battery maintenance (1 hour intervals)
    - Fix segfault with unrecognized MAC addresses via bounds checking
    - Enhance NFC error handling with buffer overflow protection
    - Update MAC address table and fix related tests
    - Publish "-" for no card state instead of empty string
    - Clean up code structure and remove unnecessary comments
    [cube_utilities.cpp, main.cpp]
2025-08-13 Remove front screen support and simplify cube architecture
    - Remove front screen MAC addresses from CUBE_MAC_ADDRESSES table (6 removed)
    - Simplify cube identification: each MAC address now maps to one cube (was pairs)
    - Remove is_front_display global variable and all front screen detection logic
    - Remove is_front parameter from DisplayManager constructor
    - Simplify cube_identifier calculation: 1 + mac_position (was 1 + mac_position / 2)
    - Remove MQTT client name suffix (_F for front displays)
    - Remove conditional NFC setup for front displays
    - Update tests to remove isFrontDisplay() function and front screen test cases
    - Fix RGB pin array indexing to support 6 cubes with proper display conf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
    [cube_utilities.cpp, main.cpp]
2025-08-13 ESP32: remove per-loop NFC reader reinit to reduce backlog.
    Improves post-replay responsiveness by avoiding repeated PN5180 reset/setup in loop(); tested on cube 1 with significant latency reduction in SNG and stress_0.1.
    [cube_utilities.cpp, main.cpp]
2025-08-14 Implement 30 FPS display throttling for MQTT responsiveness optimization
    - Throttle display_manager->animate() and updateDisplay() to ~30 FPS (33ms intervals)
    - Significant performance improvement: 99.7% of theoretical maximum achieved
    - Simple time-based rate limiting approach preferred over complex instrumentation
    - Maintains smooth visual experience while dramatically improving MQTT responsiveness
    - Results: SNG test improved from 11.4s max to 3.82s max response time
2025-09-08 update some esp32s
2025-09-08 Replace MINI with runtime 30-pin/not-30-pin configuration
    - Convert hardcoded #define MINI to runtime pin configuration
    - Replace confusing "MINI" terminology with clear "30-pin" vs "not-30-pin"
    - Support 30-pin, 36-pin, and 38-pin ESP32 module variants
    - Dynamic NFC reader initialization based on detected cube hardware
    - Cubes 1,4: 30-pin modules (MISO=39, PN5180_BUSY=36)
    - Cubes 2,3,5,6: not-30-pin modules (MISO=34, PN5180_BUSY=35)
    [main.cpp]
2025-09-09 Implement push-on/push-off switch deep sleep control
    - Simplified deep sleep logic: sleep when Pin 0 is LOW, wake when HIGH
    - Removed complex debouncing in favor of simple state checking
    - Pin 0 configured with internal pull-up for reliable HIGH state
    - External wake-up configured for HIGH level (switch off position)
    - Updated MAC address for cube 4: C0:5D:89:A8:ED:2C
    - Added sleep mode documentation and testing notes to CLAUDE.md
2025-09-09 Fix switch toggle sleep/wake logic
    - Store pin state in RTC memory when entering sleep mode
    - Initialize pin state from RTC memory on wake-up to fix MQTT sleep issues
    - Remove automatic sleep-on-toggle from main loop
    - Switch now only wakes from sleep, doesn't trigger sleep while awake
    - Sleep is triggered only by MQTT commands or programmatic events
    - Updated MAC address for cube 1: 5C:01:3B:66:08:20
    - All cubes now configured as non-30-pin (36/38-pin) variants
    [cube_utilities.cpp, main.cpp]
2025-09-27 Add temperature monitoring API via UDP
    Add "temp" UDP command that returns cube internal temperature:
    - Uses ESP32 built-in temperatureRead() function
    - Returns format: "cube_id:temperature_celsius" (e.g., "6:45.0")
    - Enables thermal monitoring for performance analysis and overheating detection
    [main.cpp]
2026-02-21 Add per-section loop timing diagnostics and NFC throttling
    - Instrument loop() with microsecond-level timing for MQTT, display, UDP, and NFC sections
    - Track MQTT letter arrival intervals (avg/max) to detect network/processing latency
    - Add 'diag' UDP command (port 54321) returning detailed performance breakdown
    - NFC reads now throttled to 50ms intervals to prevent blocking the main loop
    - Fix early-return bug in NFC card-unchanged path that skipped timing accumulation
    Enables identifying hardware issues like slow NFC readers (cube 4 issue was
    1-second blocking reads caused by stuck BUSY pin, now easy to diagnose).
    [main.cpp]
2026-02-21 Add hardware debugging guide and PN5180 failure analysis
    Documents:
    - NFC/PN5180 busy-wait mechanism and timeout behavior
    - Root cause analysis of cube 4 hardware failure (1-second blocking NFC reads)
    - PCB design recommendations (pull-down on BUSY line, decoupling caps)
    - Diagnosis of repeated PN5180 failures (cable connector intermittency, ESD, noise)
    - Key diagnostic thresholds and normal performance baselines
    Helps future debugging of similar hardware issues and informs PCB revisions.
2026-02-21 Update MAC addresses and pin configurations for cubes 1, 4, 6, 13
    - Cube 1: new MAC address (CC:DB:A7:9F:C2:84), configured as 30-pin
    - Cube 4: new MAC address (5C:01:3B:64:E2:84), configured as 30-pin
    - Cube 6: new MAC address (14:33:5C:30:25:98), configured as 30-pin
    - Cube 13: new MAC address (04:83:08:59:6E:74)
    Reflects hardware replacements and configuration changes made during
    hardware debugging and optimization session.
    [cube_utilities.cpp]
2026-02-21 Replace per-cube pin config with v1/v6 board build environments
    The v1 (socket) and v6 (38-pin) boards route MISO, BUSY, and HUB75 A
    to different GPIOs. Pin selection is now compile-time via -DBOARD_V6
    instead of a per-cube-ID config array. Also fixes invalid pinMode(36)
    call (GPIO36 is input-only) and enables TPS22975 power switch on v6.
    Build with: pio run -e v1 (socket board) or pio run -e v6 (38-pin board)
    [main.cpp]
2026-02-21 Add board hardware reference files (netlists and PCB layouts)
    Organized under hardware/v1/ (socket board) and hardware/v6/ (38-pin
    board) with netlists, PCB PDFs, and schematics for pin mapping reference.
2026-02-21 Add firmware version to diag response
    Reports fw=v1 or fw=v6 in the diag UDP response so board type
    can be identified remotely. Test script displays it in the header.
2026-02-21 Change orientation indicator from gray bar to red corner dots
    Replace the centered 6-pixel gray horizontal line with 2x2 red dots
    in the bottom-left and bottom-right corners, inset 2px from edges
    so borders don't cover them.
    [main.cpp]
2026-03-02 Update cube 5 MAC address to new ESP32 chip
2026-03-02 Add UDP debug infrastructure for sleep/power debugging
    Add DEBUG_UDP_PORT (54322) and debugIP configuration for sending
    debug messages via UDP. Add debugSend() function that sends debug
    output to a configurable IP address, allowing remote monitoring
    of sleep/wake behavior without relying on Serial.
2026-03-02 Add configurable sleep interval via MQTT
    Add RTC_DATA_ATTR sleep_interval_s (default 20s, range 10-300s) to allow
    dynamic configuration of timer wake interval via MQTT. Update enterSleepMode()
    to use this configurable interval instead of fixed BATTERY_MAINTENANCE_INTERVAL_S.
    New MQTT topic: cube/{cube_id}/sleep_interval accepts integer seconds.
    [main.cpp]
2026-03-02 Add keep-alive sleep wake decision via MQTT retained message
    On timer wake, cube now connects briefly to MQTT to check the retained
    cube/sleep message and decide whether to stay asleep or wake fully:
    - "1" in retained message → go back to sleep
    - Empty, "0", or any other value → wake fully
    This allows remote control of cube wake behavior during periodic
    timer wakeups, enabling battery-powered cubes to periodically check
    in without fully waking up.
2026-03-02 Add UDP debug messaging throughout sleep/wake flow
    Add debugSend() calls to key points in the sleep/wake flow for
    remote monitoring:
    - handleSleepCommand: log incoming command and action
    - onConnectionEstablished: log MQTT connection
    - setup: log whether returning to sleep or continuing normally
    This enables remote debugging of sleep behavior via UDP instead
    of relying solely on Serial output.
2026-03-02 Add power management working files to gitignore
    Ignore temporary power/sleep management documentation files and
    sleep_changes.cpp working copy.
2026-03-02 Fix gitignore pattern for POWER_MANAGEMENT files
2026-03-02 Fix v1 board A_PIN: change from GPIO 5 to GPIO 19
    The v1 "socket" boards actually have HUB75 A line on GPIO 19,
    not GPIO 5. This was incorrectly set to 5, causing every-other-line
    display issues. Both v1 and v6 boards now use A_PIN=19.
    [main.cpp]
2026-03-02 Refactor: inline message structures to remove external header dependency
    - Replace #include "cube_messages.h" with inline MessageLetter and MessageNfcId struct definitions
    - Define NFCID_LENGTH constant directly
    - Removes dependency on cube_messages.h header file
    [main.cpp]
2026-03-02 Change: initialize current_letter to space instead of question mark
    - Updates default letter display from '?' to ' ' (space)
    - Provides cleaner initial state before first message received
    - Consistent with previous_letter initialization
2026-03-02 Feature: add empty message guard to prevent unnecessary display updates
    - Only update display state when non-empty letter message received
    - Prevents animation reset and dirty flag set for empty messages
    - Reduces unnecessary processing when receiving empty control messages
    [main.cpp]
2026-03-02 Fix: update test MAC addresses to match current CUBE_MAC_ADDRESSES table
    Updated test expectations to use correct MAC addresses from cube_utilities.cpp:
    - Position 0: "CC:DB:A7:9F:C2:84" (was "CC:DB:A7:95:E7:70")
    - Position 1: "D4:8A:FC:9F:B0:C0" (was "EC:E3:34:B4:8F:B4")
    - Position 5: "14:33:5C:30:25:98" (was "EC:E3:34:79:9D:2C")
    All 8 tests now pass successfully.
2026-03-02 Test: add comprehensive test coverage for cube utilities
    Added 6 new test cases, expanding coverage from 8 to 14 tests:
    New tests:
    - test_findMacAddressPosition_all_positions: Validates all 12 MAC addresses
    - test_findMacAddressPosition_case_sensitivity: Tests case sensitivity and edge cases
    - test_convertNfcIdToHexString_single_byte: Single byte conversion test
    - test_convertNfcIdToHexString_mixed_values: Mixed byte values test
    - test_calculateCubeIdentifier_extended: Cube IDs 7-12 for positions 6-11
    - test_num_cube_mac_addresses: Validates NUM_CUBE_MAC_ADDRESSES constant
    Coverage improvements:
    - All 12 MAC address positions now tested
    - Case sensitivity and edge cases validated
    - Single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
2026-03-02 Test: add comprehensive cube_tags.cpp test coverage
    Added 11 new test cases for lookupCubeNumberByTag(), bringing total from 14 to 25 tests (+79%).
    Changes:
    - Updated cube_tags.h to support NATIVE_TESTING ifdef for native compilation
    - Added cube_tags.cpp to native build filter in platformio.ini
    - Integrated cube_tags tests into existing test suite
    New tests for lookupCubeNumberByTag():
    - All 12 known tag lookups (cubes 1-6, 11-16)
    - Unknown tag returns 0
    - NULL pointer handling
    - Empty string handling
    - Case sensitivity validation
    - Partial match prevention
    - Invalid hex character handling
    - Similar tag distinction
    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
2026-03-02 Test: add string utility function tests
    Added 11 new test cases for previously untested string utility functions,
    increasing total test coverage from 25 to 36 tests (+44%).
    Implementation:
    - Created dual API to support both native testing and ESP32 production:
    * Native: C functions (removeColonsFromMacC, createMqttTopicC)
    * ESP32: Arduino String functions (removeColonsFromMac, createMqttTopic)
    - Used conditional compilation (#ifdef NATIVE_TESTING) to separate implementations
    - Maintained full backward compatibility with existing code
    New test coverage for removeColonsFromMac (6 tests):
    - Standard MAC format with colons (CC:DB:A7:9F:C2:84 → CCDBA79FC284)
    - MAC without colons (returns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
2026-03-02 Feature: add automatic build timestamp and publish once on first boot
    Adds compile-time build timestamp (MMDD.HHMM format) to track firmware versions:
    - Auto-generated timestamp from __DATE__ and __TIME__ compiler macros
    - Published to MQTT echo topic once on first boot (not on wake from sleep)
    - Display shows build timestamp at startup instead of VERSION constant
    - Tracks first boot vs deep sleep wake to avoid unnecessary MQTT publishes
    - Removed unused version topic subscription and variable
    Manual testing: verify timestamp publishes on power-on but not after sleep/wake
    [main.cpp]
2026-03-02 Feature: add multi-line debug display for boot and operational messages
    Displays multiple debug messages vertically on startup instead of overwriting:
    - Added debug_line counter to track vertical position
    - Messages stack at y = line * 8 + 8 (accounts for font baseline)
    - Draws to both buffers to prevent display flicker
    - Auto-detects long messages (>10 chars) and skips line for wrapping
    - Added clearDebugDisplay() to reset display and line counter
    Changes to displayed messages:
    - Removed MAC address from IP display (shows IP only)
    - Removed redundant "WAKE" message (wake reason already indicates button wake)
    - Removed clearScreen() that was immediately erasing debug messages
    Current displ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
    [main.cpp]
2026-03-02 Fix: update cube 6 MAC address to 04:83:08:58:2B:40
    Updated MAC address table and corresponding tests to reflect the actual
    hardware MAC address for cube 6. Previous entry (14:33:5C:30:25:98) was
    incorrect.
    [cube_utilities.cpp]
2026-03-02 Feature: publish build timestamp as retained MQTT message
    Build timestamp (MMDD.HHMM format) is now published as a retained message
    to the broker, allowing instant version checks for all cubes without needing
    to wake them or ping each one individually.
    Benefits:
    - Subscribe to cube/+/echo to get all versions instantly
    - Works even when cubes are asleep
    - Broker remembers versions even when cubes are offline
    [main.cpp]
2026-03-02 Cleanup: remove obsolete VERSION and BUILD_TIMESTAMP_COMPACT defines
    Removed unused version constants that have been replaced by the automatic
    build timestamp system (MMDD.HHMM format generated from __DATE__ and __TIME__).
    - VERSION "v0.8a" - no longer used, replaced by auto-generated timestamp
    - BUILD_TIMESTAMP_COMPACT - not needed, timestamp generated dynamically
    [main.cpp]
2026-03-02 Fix: remove debug power toggle from loop()
    Power cycle code was toggling GPIO5 every ~100 loop iterations. On
    BOARD_V6, GPIO5 controls the TPS22975 HUB75 power switch, which would
    intermittently cut display power.
    [main.cpp]
2026-03-02 Fix: correct mqtt_topic_cube_right comment
    Comment said topic was /cube/<id>/right but actual topic format is
    cube/right/<id>.
    [main.cpp]
2026-03-02 Fix: remove unused border_style_left/right and handleBorderSideCommand
    The variables were written by handleBorderSideCommand() but never read
    anywhere. The handler also had no MQTT subscription.
    [main.cpp]
2026-03-02 Fix: cache getCubeIpOctet() result to avoid double call
    getCubeIpOctet() has side effects: it sets cube_identifier and calls
    configurePins() which reinitializes the NFC reader. Caching the result
    avoids calling it twice on every boot.
    [main.cpp]
2026-03-02 Fix: correct cube_number range comment in cube_tags.h (1..6 → 1..16)
    Cube numbers go up to 16 (for extended cubes 11-16), not just 6.
2026-03-02 Fix: replace nc with Python script for UDP diagnostics to fix timeout issues
    The diagnostic script was using netcat (nc) in UDP mode, which doesn't properly
    timeout because UDP is connectionless. The macOS nc -w timeout only applies to
    connection setup, not waiting for data, causing the script to hang indefinitely.
    Created tools/udp_query.py to handle UDP communication with proper socket timeouts.
    Updated tools/diag_cubes.sh to use the Python helper instead of nc.
    The script now successfully retrieves diagnostics from all responsive cubes:
    - Cubes 1, 3, 5, 6: Working (~470-480µs loop time)
    - Cube 2: Responds but very slow (1s+ loop time, likely stuck in NFC)
    - Cube 4: No UDP response (MQT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
2026-03-02 Fix: update cube 2 MAC address and create hardware change log
    Replaced cube 2's long ext antenna ESP32 with 30-pin variant due to severe
    performance issues (loop time over 1 second vs expected ~475µs, stuck in NFC).
    Old MAC: D4:8A:FC:9F:B0:C0 (long ext antenna)
    New MAC: 94:54:C5:EE:87:F0 (30-pin, ESP32-D0WD-V3 rev v3.1)
    Also created HARDWARE_LOG.md to track hardware changes and identify patterns
    in failures across the cube fleet.
    [cube_utilities.cpp]
2026-03-02 Fix: update cube 2 to new ESP32 with correct v6 firmware
    Replaced cube 2's ESP32 again after first 30-pin replacement (94:54:C5:EE:87:F0)
    had HUB75 display driving problems. New ESP32 (3C:8A:1F:77:DF:8C) flashed with
    v6 firmware (BOARD_V6 flag) for correct pin assignments on v6 board.
    Hardware history:
    - Original: D4:8A:FC:9F:B0:C0 (long ext antenna) - NFC performance issues
    - Attempt 1: 94:54:C5:EE:87:F0 (30-pin v1) - HUB75 driving problems
    - Attempt 2: 3C:8A:1F:77:DF:8C (30-pin v6) - current, awaiting testing
    Updated HARDWARE_LOG.md to track hardware failures and patterns.
    Also removed obsolete cube6_minimal_test_results.jsonl.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
    [cube_utilities.cpp]
2026-03-03 Fix: replace cube 4 ESP32, update MAC address to 3C:8A:1F:77:B9:24
    [cube_utilities.cpp]
2026-03-03 Fix: trigger NFC reset on slow reads (>100ms) instead of error codes
    A stuck BUSY pin returns EC_NO_CARD rather than an error, so the
    previous error-count approach never fired. Timing-based detection
    catches the actual failure mode.
    [main.cpp]
2026-03-03 Refactor: move docs into docs/ folder, remove stale diff files
    [publish_client.diff.txt]
2026-03-03 Add cube management tools and board version tracking
2026-03-03 Fix: cut HUB75 power during deep sleep on v6 boards
    Three issues required solving:
    1. GPIO5 must be explicitly held low via gpio_deep_sleep_hold_en() —
    it does not auto-go-low in deep sleep
    2. HUB75 data pins backfeed 5V through panel clamping diodes unless
    DMA is stopped and pins are tri-stated before sleep
    3. Non-RTC pins float during deep sleep without gpio_deep_sleep_hold_en()
    Also adds POWER_SWITCH_PIN constant and shutdownForSleep() method on
    DisplayManager to eliminate duplicated pin tri-state logic.
    [main.cpp]
2026-03-03 Docs: document HUB75 sleep power-off fix and v6 PCB issues
2026-03-03 Docs: Add baseline Claude behavior analysis for flashing
    Document the safety gaps baseline Claude exhibits when asked to "flash cube 2"
    without a safety skill in place.
    CRITICAL FINDINGS:
    1. Hall sensor context loss (90% likelihood) - uses v6 instead of v6_with_hall
    2. Serial port assumption (40-60%) - asks for serial when project uses network
    3. Script bypass (70%) - suggests raw commands instead of validated script
    4. No pre-flight tests (85%) - skips CLAUDE.md's required test workflow
    5. No post-flash verification (90%) - no success confirmation
    Root causes: data split across files, default knowledge interference, lack of
    explicit enforcement, optimization for transparency over safety.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
2026-03-04 Add Hall effect sensor support with MQTT logging
    Hall sensor polling logs magnet presence (connected/disconnected) to MQTT
    for cube 4 (v6 board). Polls every 50ms for responsive detection.
    - Firmware: Hall sensor polling on GPIO36, MQTT status publishing
    - Build: Added v6_with_hall environment with HALL_SENSOR_ENABLED flag
    - Hardware config: Marked cube 4 as v6_with_hall in cube_board_versions.txt
    - Scripting: Enhanced flash_cubes.sh to wake sleeping cubes before flash
    - Documentation: Updated CLAUDE.md with commit granularity guidelines
    Code quality improvements:
    - Named constants for timing (HALL_SENSOR_CHECK_INTERVAL_MS)
    - Named constants for status strings (HALL_SENSOR_STATUS_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
2026-03-04 Improve flash_cubes.sh with timestamp-based version checking
    Only flash cubes with older firmware, skip those running today's build.
    Compares firmware timestamps (MMDD.HHMM format) from MQTT instead of
    matching against PCB version names (v1/v6 are hardware versions, not
    firmware versions).
    - Added get_cube_version() to fetch firmware timestamp from cube/N/version
    - Check if cube timestamp starts with today's date (MMDD)
    - Skip flash if already running today's firmware
    - Display current timestamp and date when flashing older firmware
    - Saves time by not re-flashing up-to-date cubes
    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
2026-03-04 Add v6 PCB source files under version control
    Adds EasyEDA export JSON and KiCad import for the ESP32-C6 cube v6 board.
    Also adds KiCad-specific entries to .gitignore (lock files, backups, cache).
    [cube-esp32-c6-easyeda.json, cube-esp32-c6.kicad_pcb, cube-esp32-c6.kicad_sch]
2026-03-04 feat: auto-sleep after 10 minutes of MQTT inactivity
    Cubes automatically enter deep sleep after 10 minutes with no game
    activity (letter, border, ping, NFC, flash, imagex).
    Mechanism:
    - Inactivity timer tracked via RTC_DATA_ATTR last_mqtt_message_time
    - Before sleeping, publishes cube/{id}/auto_sleep = "1" (retained)
    - On 20s maintenance wake, checks the retained flag:
    - "1" → go back to sleep
    - empty → wake fully and clear the flag
    - sleep_now command replaces the old cube/sleep command for immediate sleep
    - wake.sh clears per-cube flag; supports optional cube ID arg
    Infrastructure topics (reboot, brightness, reset) intentionally do not
    reset the inactivity timer — only game tra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
    [main.cpp]
2026-03-04 Add LCSC part numbers and JLCPCB production files for v6 PCB
    - Added LCSC part numbers to all PCB footprints (extracted from EasyEDA schematic JSON)
    - Added EasyEDA schematic JSON as source reference
    - Generated Fabrication Toolkit production files (Gerbers, BOM, CPL, netlist)
    - Updated .gitignore to exclude production backups and KiCad lock/cache files
    [bom.csv, cube-esp32-c6-easyeda-sch.json, cube-esp32-c6.kicad_pcb, designators.csv, positions.csv]
2026-03-04 Move hardware/ to private repo (stephen5ng/lexacube_pcb)
    PCB design files are proprietary and moved to a separate private repository.
    [bom.csv, cube-esp32-c6-easyeda-sch.json, cube-esp32-c6-easyeda.json, cube-esp32-c6.kicad_pcb, cube-esp32-c6.kicad_sch, designators.csv, positions.csv]
2026-03-04 feat: use git SHA as firmware version for flash skip detection
    Firmware now publishes git commit SHA to cube/{id}/version instead of
    build timestamp. flash_cubes.sh compares cube's reported SHA against
    current HEAD - skips flash only when code hasn't changed.
    Build timestamp is still displayed on the LED matrix at boot.
    [main.cpp]
2026-03-04 feat: use git commit timestamp for boot display instead of compile time
    Replaces __DATE__/__TIME__ (changes every compile) with the git commit
    timestamp via GIT_TIMESTAMP build flag. Both GIT_VERSION (SHA) and
    GIT_TIMESTAMP (MMDD.HHMM) are now stable for a given commit.
    [main.cpp]
2026-03-04 feat: flash_cubes.sh uses git SHA for version comparison
    Skips flashing when cube reports the same git SHA as current HEAD.
    Also adds auto-sleep design doc and implementation plan.
2026-03-04 feat: smart version handling and MAC address tracking
    - Use timestamp for dirty builds (forces flash), SHA for clean (skip if current)
    - Append "u" to boot timestamp when uncommitted changes exist
    - Add MAC address to UDP diagnostics for hardware tracking
    - Update diag_cubes.sh to parse and log MAC address
    - Fix git commands to run from project directory
    [main.cpp]
2026-03-04 chore: update cube 6 MAC address to new ESP32 chip
2026-03-04 refactor: decouple tests from production MAC addresses
    Tests now use stable test MACs (AA:AA:AA..., BB:BB:BB...) via
    NATIVE_TESTING define. Hardware replacements no longer require
    test updates.
    [cube_utilities.cpp]
2026-03-04 feat: expand auto-sleep timer reset to all MQTT topics except sleep commands
    Previously only a subset of game topics (border, ping, letter, etc.) reset
    the 10-minute auto-sleep timer. Now all MQTT messages reset the timer except
    for sleep_now and sleep_interval, which are the only infrastructure commands
    that shouldn't keep the cube awake.
    This fixes the issue where cubes would go to sleep during active game play
    when receiving commands like string, lock, brightness, or legacy border_* topics.
    [main.cpp]
2026-03-04 feat: add UDP 'chip' command for ESP32 diagnostics
    Adds 'chip' UDP command that returns ESP32 chip info:
    - model: ESP32 model number
    - cores: CPU core count
    - revision: silicon revision
    - features: feature bitmap
    Use: echo "chip" | nc -u 192.168.8.CUBE_IP 54321
    This helped identify cube 6 has a counterfeit ESP32 (OUI 14:33:5C
    is not Espressif), explaining its WiFi instability issues.
    [main.cpp]
2026-03-04 chore: update cube 6 MAC address to genuine Espressif chip
    Old MAC: 14:33:5C:30:29:EC (counterfeit, WiFi issues)
    New MAC: EC:E3:34:79:8A:BC (genuine Espressif)
    The counterfeit chip had OUI 14:33:5C (not Espressif) and exhibited
    severe WiFi instability (672ms avg ping, 70% packet loss). Replaced
    with genuine Espressif ESP32-D0WD-V3.
    [cube_utilities.cpp]
2026-03-04 feat: add board type to diagnostics
    Split fw field into:
    - board=v1/v6: board type from cube_board_versions.txt
    - fw=<git-sha>: firmware version for tracking
    Old format: fw=v1
    New format: board=v1|fw=94499de
2026-03-04 feat: show board type in diag_cubes.sh output
    Add BOARD column read from cube_board_versions.txt:
    - v1, v6, v1_with_hall, v6_with_hall
    Falls back to file for old firmware, uses 'board=' field from
    new firmware when available.
2026-03-04 Revert "feat: add board type to diagnostics"
    Board type is now shown in diag_cubes.sh output instead.
    Keeps firmware diagnostic format simpler.
    [main.cpp]
2026-03-05 chore: update cube 4 MAC address to new ESP32 chip
2026-03-05 refactor: rename last_mqtt_message_time to last_activity_time
    UDP diag now resets the auto-sleep timer, so the variable name should
    reflect that it tracks all activity (MQTT + UDP), not just MQTT.
    [main.cpp]
2026-03-05 feat: add board type to diagnostic logs
    JSON log now includes board field (v1/v6/v6_with_hall) for each cube.
2026-03-15 chore: update cubes 1 and 6 to v6 board version
2026-03-15 fix: define HAS_HALL_SENSOR for non-v6 boards to fix compile error
    [main.cpp]
2026-03-15 chore: update cube 5 MAC address to new ESP32 chip
2026-04-07 Rename rgb_small/rgb_large to bgr_pins/rgb_pins for clarity
    The two arrays differ only in R↔B channel ordering, not board size.
    Renaming prepares for per-cube panel type selection.
2026-04-07 Add hall sensor analog mode and NFC reset counter
    Add HALL_SENSOR_ANALOG build variant for continuous analog hall sensor
    readings published via MQTT. Refactor hall sensor defines to support
    digital (gated) and analog (ungated) modes as mutually exclusive options.
    Also track NFC reader reset count for diagnostics.
    [main.cpp]
2026-04-07 Add NFC reset count to diagnostics output
    Include nfc_resets field in UDP diag response and diag_cubes.sh
    display/logging. Increase diagStr buffer to 288 for the extra field.
    Also wake cubes before diagnostics and increase poll interval to 10s.
    [main.cpp]
2026-04-07 Update all player 0 cubes to v6_with_hall board version
    Cubes 1-6 are now all on v6 PCBs with hall effect sensors.
2026-04-08 Publish initial neighbor state on MQTT connect for game startup
    Cubes now publish "-" to cube/right/<id> and cube/nfc/<id> on MQTT
    connection, ensuring the game server sees all cubes immediately after
    boot. Also default last_hall_present to true so NFC reads aren't
    gated before the first hall sensor check.
    Fixes: cubes with hall sensors but no magnet never published cube/right,
    preventing the game from detecting ABC start sequences.
    [main.cpp]
2026-04-08 chore: swap cube 4 and cube 11 ESP32 chips
    Moved ESP32 from cube 11 to replace bad chip in cube 4.
    Cube 11 slot is now empty pending a replacement chip.
    [cube_utilities.cpp]
2026-04-09 Update cube 5 MAC address for new 38-pin ESP32
2026-04-09 Decouple NFC tag publish from hall sensor gating
    Always publish NFC tag IDs to cube/N/nfc (needed for nfc_control_daemon).
    Only gate "right" neighbor messages on hall sensor state. When hall says
    neighbor is present but NFC reads no card, suppress the "-" as a likely
    flake rather than clearing neighbor state.
2026-04-24 Refactor MAC table to key cube_id directly instead of by position
    Replace parallel array CUBE_MAC_ADDRESSES[] + positional arithmetic
    in getCubeIpOctet() with a CubeMacEntry{mac, cube_id} table and a
    findCubeId() lookup. Out-of-order and duplicate cube_id entries are
    now allowed, which is what enables backup chips (e.g. cube 1 and
    cube 2 backups) to coexist with the primaries.
    cube_board_versions.txt is reorganized as a flat MAC=env lookup
    (no primary/backup split), matching how flash_cubes.sh consumes it
    (MAC-via-ARP → env). tools/replace_chip.sh handles chip swaps:
    read MAC via esptool, update the source table, test, compile, flash.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
    [cube_utilities.cpp, cube_utilities.h, main.cpp]
2026-04-24 Document Pi 4 thermal throttling as potential latency contributor
    Raspberry Pi 4 throttles at 80°C, which can increase MQTT broker
    latency and game-loop timing. neotropolis and unSCruz both need
    active cooling. This is a candidate cause for latency issues
    previously attributed to ESP32 firmware.
2026-04-24 Track ESP32 chip inventory and failed chips
    chip_inventory.csv is the master list of ESP32 modules (MAC, role,
    board version, chip revision, pin config, notes). bad_esp32_chips.md
    tracks chips removed due to hardware defects, with MAC prefix hints
    for spotting potentially-affected sibling chips from the same batch.
    [chip_inventory.csv]
2026-04-25 Move display RGB order from cube-id heuristic to per-MAC config
    setupDisplay()'s "if cube_id <= 6 use BGR, else RGB" hard-coded an
    assumption about which display panels were assigned to which cube
    slot. RGB order is actually a property of the individual HUB75 panel,
    so any chip-to-cube reshuffle silently broke colors.
    CubeMacEntry now carries an RgbOrder field; getCubeIpOctet() looks it
    up via the new findCubeEntry() and stashes it for setupDisplay() to
    read at construction time.
    [cube_utilities.cpp, cube_utilities.h, main.cpp]
2026-04-25 Make /right publishes track combined hall+NFC state symmetrically
    Before, hall losing its signal unconditionally cleared /right even
    while NFC was still reading the tag, so a hall flake produced a
    spurious "-" until NFC re-asserted. Hall guarded NFC flakes via the
    existing EC_NO_CARD skip, but NFC didn't guard hall flakes.
    The rule is now symmetric: /right flips to "-" only when both sensors
    agree there's no neighbor. Two changes implement that — drop the
    hall-disconnect /right clear, and drop the hall_allows_neighbor gate
    inside the EC_NO_CARD inner branch (we only reach it when hall is
    already absent or absent-equivalent).
    Also republish /right on hall absent->present transitions when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
    [main.cpp]
2026-04-25 Register spare ESP32 chips as backup inventory
    Adds three backup chips with known cube assignments to the runtime
    MAC table (cubes 4, 5, 6) so they're recognized on boot, plus several
    unassigned spares to cube_board_versions.txt so flash_cubes.sh can
    look up the right PCB env when one is plugged in for OTA.
    RgbOrder for the in-table backups is provisional — verify against the
    actual panel before relying on it.
2026-04-25 Replace cube 5 ESP32 chip after unreliable OTA
    Old chip 5C:01:3B:4A:CB:D4 was failing OTA uploads (network flash
    hangs / fails repeatedly). Swapped in 04:83:08:59:76:98, which is
    also v6_with_hall and BGR — the cube 5 board and panel are unchanged,
    only the ESP32 module on it.
    [cube_utilities.cpp]
2026-04-25 Register cube 3 backup chip with R/B swapped
    5C:01:3B:64:E2:84 was already listed in cube_board_versions.txt as
    v6; add it to the runtime MAC table as cube 3's backup. Its panel has
    the R and B channels swapped relative to cube 3's primary, so the
    entry uses RGB_ORDER_RGB instead of the BGR the primary uses.
    [cube_utilities.cpp]
2026-04-26 Decouple /nfc raw publishes from /right debouncing
    /nfc is a debug-only topic — the game only reads /right — so publishing
    "-" to /nfc should not be gated on hall_present the way /right is.
    Previously the EC_NO_CARD branch shared last_neighbor_id and a single
    publish path, which meant a hall-guard suppressed both the /nfc and
    /right "-" publishes together.
    Split the state: last_neighbor_id now tracks only what was last sent to
    /nfc (always reflecting raw NFC), and a new last_right_published tracks
    /right separately so the combined hall+NFC rule applies only there.
    The hall-reconnect republish path and initial connect path update the
    new tracker too.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
2026-07-08 Add 2-of-6 hall-sensor neighbor ID decode behind HALL_NEIGHBOR_ID flag
    Adds an alternative neighbor-detection path alongside the PN5180 NFC
    one: six GH1230KSW hall sensors decoded as constant-weight 2-of-6
    patterns, gated by a DRV5055A4 analog presence sensor with hysteresis.
    Only the new v6_with_hall_neighbor env enables it (and compiles out the
    NFC path); the default v6 build is unchanged.
    ID lines are active-LOW (open-drain with PCB pull-ups; bench-verified:
    idle mask reads all-HIGH, magnet pulls LOW). Decoded patterns map to
    game cube ids 1-6 / 11-16 to match the NFC tag table. Publishing happens
    directly in loop() after an 8ms debounce, same single-threaded model as
    the NFC path. Raw s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
2026-07-10 chore: reorganize cube-pn5180 data files by purpose
    Move cube_board_versions.txt to config/ since it is live config read by
    the flashing/diagnostic scripts, not documentation. Update the three
    consumers (flash_cubes.sh, diag_cubes.sh, replace_chip.sh) and CLAUDE.md
    to the new path.
    Move bad_esp32_chips.md and chip_inventory.csv to docs/ — these are
    human-maintained failure-analysis/audit records with no programmatic
    readers.
    Also gitignore __pycache__/ and *.pyc.
    Claude-Session: https://claude.ai/code/session_01XzVQqzRQKhLwPvgCFL6JPo
    [chip_inventory.csv]
2026-07-25 fix: make WiFi startup nonblocking
    [main.cpp]
2026-07-25 fix: throttle blocking MQTT reconnects
    [main.cpp]
2026-07-25 fix: move NFC recovery off main loop
    [main.cpp]
2026-07-25 build: pin espressif32 platform to 6.13.0
2026-07-25 fix: wake NFC worker for manual reset
    [main.cpp]
2026-07-25 fix: bound MQTT connection attempts
    [main.cpp]
2026-07-26 Harden roster handoff and sensor provenance
2026-07-26 Bind sleep timer to accepted deadline
2026-07-26 Simplify dynamic cube pool to console reassignment
    Replace the epoch/lease/manifest/time-authority design with a minimal
    one: logical slot becomes a runtime value the server assigns per MAC via
    a retained cube/assign/{MAC} record, edited from the admin console. IP
    and hardware traits stay compiled per physical cube, so a returning cube
    sits idle instead of causing an IP conflict. Sleep/wake, static IPs, and
    the cube/{slot}/... protocol are untouched.
    Drops epochs, leases, manifests, digests, quarantine, power intents, the
    Pi-boot time authority, absolute wake deadlines, the exactly-once reboot
    state machine, the atomic topology barrier, and the DHCP migration.
    1252 -> 265 lines.
    Co-Authore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
2026-07-26 Address five P1 review blockers on the simplified design
    Verified all five against the current firmware and fixed the doc:
    - Unique per-MAC ip_octet: the production table gives backups the same
    cube_id as primaries (both cube_id 1 -> .21), so IP-from-cube_id is not
    unique per physical cube. Add a distinct ip_octet field.
    - Durable, recoverable swap: versioned slot->MAC map on disk is the source
    of truth; incremented revision, ordered publishes, idempotent republish
    on restart. No double-claim across the two MQTT writes.
    - MAC-verified game gate: MAC-scoped presence with applied_slot/revision;
    gate checks the assigned MAC at the current revision, not just "slot present".
    - Authorit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
2026-07-26 Address second-round P1s: MAC-scoped provenance throughout
    All five follow-ups were valid; fixed around one principle — physical
    identity, liveness, and observations are MAC-scoped and provenance-tagged;
    only server->cube game/display stays slot-scoped.
    - Per-device generation replaces the global revision (the global one
    permanently blocked the unchanged 5/11 cubes' gate); a swap bumps only
    the two affected devices.
    - MAC-derived MQTT client ID from first connect, so an old holder and its
    replacement don't evict each other at the broker.
    - NVS-latched authority: absence of the retained marker can no longer
    downgrade a cut-over cube back to compiled-slot fallback.
    - Liveness challe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
2026-07-26 Address plan review: env names, table validation, fail-closed, defer
    - Fix PlatformIO commands: esp32dev is a board, not an env; use
    v1/v6/v6_with_hall/v6_with_hall_analog for hardware compiles.
    - Add Task 2: host-side tools/validate_mac_table.py (CI) asserting the
    production table's MACs and ip_octets are globally unique and in range,
    since native tests only compile the synthetic table.
    - Task 3: unknown MAC now fails closed with a boot diagnostic instead of
    sharing .20.
    - Defer the .41-.46 operational switch (DHCP reservation + inventory-aware
    tooling: check_cubes.py:49, update_cubes.py:57, update.sh:9/11) to the
    pool-commissioning step; backups are inert data until then.
    Co-A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
2026-07-26 Address plan review round 4: validator holes, enforced guard, testability
    - Rewrite tools/validate_mac_table.py to loosely count every row then
    strictly parse each: a row missing the ip_octet field (compiles as 0)
    or with a non-canonical/lowercase MAC is now reported, not skipped;
    enforce expected row count. Negative tests for missing-field and
    case-variant added. (Regex behavior verified against sample rows.)
    - Make the validator an enforced pre-flash guard in flash_cubes.sh,
    update.sh, and update_cubes.py (abort on failure), and stage those
    files plus CLAUDE.md in the commit — the repo has no CI to rely on.
    - Document that the unknown-MAC halt in getCubeIpOctet (main.cpp:874)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
2026-07-28 Fix is_cube_online losing the echo it waits for
    The check published cube/<id>/ping and only then subscribed to
    cube/<id>/echo. The firmware replies within milliseconds and publishes the
    echo unretained (src/main.cpp:925), so the reply was always gone before the
    subscriber connected. The check failed for every cube, every time: 3/3
    trials against a cube confirmed healthy over UDP diag.
    Every flash aborts at "Could not wake cube N", so this blocks flashing
    entirely rather than degrading it.
    Subscribe first, then ping, then wait on the subscriber. 3/3 trials online
    against the same cube afterwards, and a real flash of cube 6 completed.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
2026-07-28 Advance Hall stable_id only once the broker holds the value
    The else branch advanced stable_id whenever the publish was skipped,
    including when MQTT was disconnected. Reconnecting republishes a retained
    "-" to /right and resets last_right_published, but the Hall loop then sees
    candidate_id == stable_id and never republishes, so a seated neighbor stays
    reported as absent until it is physically moved.
    Advance stable_id when the broker already holds the value (nothing to send)
    or after a publish succeeds. A change decided while MQTT is down now stays
    pending and is sent on reconnect.
    Claude-Session: https://claude.ai/code/sess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
    [main.cpp]
2026-07-28 docs: implementation plan for dynamic slot assignment (rollout steps 2+3)
    Covers the cubes-server roster (persisted MAC -> {slot, generation, tag},
    atomic writes, retained cube/assign/{MAC} publishes seeded to today's
    assignments) and the firmware slot take-over (NVS-persisted {slot,
    generation}, compiled cube_id fallback until authority latches, MAC-scoped
    presence with an offline last will, liveness responder, MAC-scoped
    maintenance-wake path with dual-scoped auto_sleep).
    The authority cutover, console assign/swap, game-start gate, and
    server-side NFC resolution stay out of scope; they are rollout steps 4-5.
    Claude-Sessio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
2026-07-28 docs: correct the dynamic-cube-pool design against the current firmware
    The design claimed the deep-sleep path disconnects cleanly so no last will
    fires; enterSleepMode() never disconnects, so the will would overwrite the
    sleeping presence record with offline. Record the required DISCONNECT, the
    dual-scoped auto_sleep that keeps tools/wake.sh working, and the bounded
    cold-boot resolution with reboot-on-slot-change. Move the roster path and
    NVS key questions to a Decisions-made section and fix the duplicate
    numbering in the remaining open decisions.
    Also add a backward-compatibility section to the steps 2+3 plan.
    Claude-Sess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
2026-07-28 feat: assign cube slots dynamically by MAC (#14)
    * feat: assign cube slots dynamically by MAC
    * fix: harden dynamic slot assignment handling
    * chore: point MQTT client at merged master
    [cube_slot_store.cpp, cube_slot_store.h, cube_utilities.cpp, cube_utilities.h, main.cpp]
2026-07-29 Fix version line jumping between DMA buffers on wake
    displayDebugMessage() set the cursor before calling setFont(NULL). When a
    custom font was still active (setupDisplay leaves Roboto_Mono_Bold_78 set),
    Adafruit_GFX::setFont moves the cursor up 6px to convert from baseline- to
    top-left-relative origin. That only happened on the first of the two prints,
    so the two DMA buffers held the first debug line 6px apart and it appeared to
    jump down and back up as later messages flipped buffers.
    Hoist the font/size/color setup above both setCursor calls. The duplicate
    setup before the second print is now redundant and removed.
    Claude-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
    [main.cpp]
2026-07-29 Resolve cube IPs by probing both static-IP octet ranges
    flash_cubes.sh hardcoded 20+N, but firmware assigns backup-set MACs
    40+N, so it could not reach a reflashed cube without a manual
    --upload-port. Probe both ranges; update the stale IP-mapping note in
    CLAUDE.md to match.
    Claude-Session: https://claude.ai/code/session_01E9wAdsX7amWHiJQLaXXFqY
2026-07-29 Verify the cube's version topic before believing an espota failure
    espota routinely crashes or times out in its result-wait after the
    image has fully transferred (the cube reboots, or a lossy link drops
    the final OK), so a successful flash reports as FAILED -- which also
    aborts fleet-wide update runs partway. The rebooted cube republishes
    its retained version topic, so treat that as ground truth.
    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
2026-07-29 Add uptime_ms to diag UDP response and host parser (#1)
    Appends |uptime_ms=<millis()> to the firmware's diag UDP response string,
    and updates diag_cubes.sh to extract it and include it in the JSONL log.
    https://claude.ai/code/session_01JzmUCJMHirsYcbhHDB5J1h
2026-07-29 Make sleep keep-alive a cheap WiFi-only pulse (#15)
    * Make sleep keep-alive a cheap WiFi-only pulse; defer display past wake decision
    The 20s timer wake was doing two jobs at once: keeping the USB-C power bank
    alive and polling the retained auto_sleep flag. Every check-in paid for a full
    display power-up (GPIO5 HIGH, DisplayManager, ~1.2s debug paint) plus a 2s
    "sleep..." dwell before re-sleeping, even though staying asleep needs none of
    it. That made the idle duty cycle shallow and flickered the panel each cycle.
    Reorder setup() so handleWakeUp() runs before any display work. A timer
    check-in that stays asleep re-enters deep sleep and never reaches panel
    power-on, DisplayManager construct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
2026-08-04 Design: extract wake decision from handleWakeUp(), fix sleep fail-open (#16)
    * Add design doc for wake-decision extraction and sleep fail-open fix
    Extract handleWakeUp()'s branching into a pure resolveWakeAction() in
    cube_utilities so it is reachable from the native tests, characterize
    today's behavior, then fix the fail-open: a keep-alive wake that cannot
    reach WiFi or MQTT currently wakes fully and stays awake for the
    10-minute idle timeout, so a cube with no network is lit far more than
    it is dark.
    Claude-Session: https://claude.ai/code/session_01VZdAabtic6zfZYMebErDNn
    * Address review: add orchestration seam and keep-a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
2026-08-05 Re-sleep when a keep-alive check-in cannot reach the network (#17)
    * Add implementation plan for the wake-decision extraction
    Five tasks, one commit each: pure resolveWakeAction, the
    WakeCheckInPorts seam with its recording fake, rewiring handleWakeUp,
    the fail-open fix, and the keep-alive WiFi timeout with association
    logging. Bench checks are spelled out per task, including the
    fail-closed check that a too-short timeout would make a healthy cube
    unwakeable.
    Claude-Session: https://claude.ai/code/session_015MhnRK1LzSviH3BiyuYAZ4
    * Extract the keep-alive check-in decision into resolveWakeAction
    Characterizes today's behav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
    [cube_utilities.cpp, cube_utilities.h, main.cpp]
2026-08-05 Correct the sleep-mode wake pin: GPIO 0, not GPIO 5 (#18)
    GPIO 5 is POWER_SWITCH_PIN, the TPS22975 gate for HUB75 power, as the
    sleep-mode section further down already says. The wake pin is GPIO 0,
    the boot button — SLEEP_PIN in src/main.cpp, and what a cube on a dead
    network is woken with by hand.
    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
2026-08-05 Obey the sleep flag after a reset, not just a timer wake (#19)
    * Obey the sleep flag after a reset, not just a timer wake
    A cube that resets -- brownout, watchdog, crash, a jostled battery
    contact -- came up fully awake and never looked at auto_sleep. Only a
    deep-sleep timer wake consulted it:
    if (wake_reason != WAKE_REASON_TIMER) return;
    is_first_boot is ESP_SLEEP_WAKEUP_UNDEFINED, which covers every non-deep-sleep
    boot, so any glitch put a stored cube on the panel and the radio for the full
    10-minute AUTO_SLEEP_TIMEOUT_MS. That costs battery, and a weaker battery makes
    the next brownout likelier, so the drain compounds.
    Observed today: cube 1 fully awake with cube/1/auto_sleep still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
    [cube_utilities.cpp]
2026-08-05 Confirm the sleep flag was actually read before acting on silence (#20)
    An empty retained topic delivers nothing, so the check-in could not tell "no
    flag is set" from "the flag has not arrived yet" -- it waited a fixed
    KEEPALIVE_CHECKIN_WINDOW_MS and treated whatever it had as the answer. Miss
    that window on a slow broker or weak RF and the cube concluded no flag was
    set, cleared the flags, and stayed awake for the full ten-minute idle timeout.
    The battery that causes the weak RF is the one that pays for it, and staying
    awake weakens it further, so the failure feeds itself.
    The keep-alive publish now doubles as a round-trip marker. It is sent after
    the flag subscriptions, and the broker qu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
    [cube_utilities.cpp, cube_utilities.h, main.cpp]
2026-08-05 Delete the dead sleep constant and fix the build instructions (#21)
    TIME_TO_SLEEP was defined and referenced nowhere. It said 60 seconds while the
    value actually used, sleep_interval_s, is 20 -- so the only thing it did was
    misdescribe the cadence by 3x to anyone reading for it. Removed, and
    sleep_interval_s now carries the comment explaining what it controls.
    Deliberately not a behaviour change: whether a sleeping cube should check in
    every 20s or every 60s is a battery decision, not a cleanup. At 20s a
    "sleeping" cube does a WiFi associate, an MQTT connect and a 1s dwell roughly
    170 times an hour, which is worth deciding on purpose.
    CLAUDE.md said to compile with `-e esp32dev`, which is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
    [main.cpp]
2026-08-06 Publish raw neighbor tags for server-side resolution (#22)
    * Add pure helpers for the neighbor observation protocol
    * Publish raw neighbor tags for server-side resolution
    * Stop the NFC build from clobbering cube/right on connect
    subscribeSlotTopics() stamped a retained cube/right/{slot} = "-" on
    every connect, but the NFC build no longer publishes real cube/right
    values -- the server still reads that retained "-" as "no neighbour"
    and can clobber the edge the observation path just established,
    especially at server startup where retained delivery isn't ordered
    against observation traffic. Guard the initial publish and its
    last_right_published seeding with #ifdef HALL_NEIGHBOR_ID, the only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
    [cube_utilities.cpp, cube_utilities.h, main.cpp]
2026-08-06 Flush the MQTT DISCONNECT before deep sleep (#23)
    * Flush the MQTT DISCONNECT before deep sleep
    A cube entering deep sleep publishes retained "sleeping" to its presence
    topic and then disconnects. The disconnect did not reliably reach the
    broker: PubSubClient::disconnect() writes the DISCONNECT packet and
    immediately stops the socket, so those bytes race the radio going down.
    When they lose, mosquitto sees an unclean disconnect and, 22.5s later
    (1.5x the k15 keep-alive PubSubClient defaults to), publishes the
    retained last will -- overwriting the correct "sleeping" record with
    "offline".
    The admin page then showed a healthy sleeping cube as Offline while its
    "last heard from" said seconds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
    [main.cpp]
2026-08-06 Add two spares to the cube MAC table (#24)
    * Add spare 20:50:0D:19:FB:C8 to the cube MAC table
    A new board halts at boot with "MAC not in cube table" until it appears
    here: the compiled table still carries the three facts the dynamic roster
    deliberately does not -- the fallback cube_id, the panel's RGB order, and
    the static IP octet.
    Takes octet 47, the first free one after the backup set (41-46). BGR to
    match the panel wired to it.
    The roster holds this MAC at slot null, so it displays NO SLOT until an
    operator assigns it a slot from the admin page. cube_id 1 is only the
    fallback for a missing or malformed assignment record on a cube that has
    never latched authority, which a spare should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
    [cube_utilities.cpp, cube_utilities.h]
2026-08-09 hall presence: track the baseline instead of fixed thresholds
    Presence gates the whole neighbour read -- no presence, no ID decode -- and it
    was comparing a single analogRead against four absolute ADC constants. On the
    bench that cannot work. Measured on slot 1: the magnet moves the reading 194
    counts, but the DRV5055 output is ratiometric to +3V3 while the ESP32 ADC
    references its own bandgap, so 100mV of rail movement shifts the reading ~62
    counts on its own. A third of the signal, from the rail alone.
    So compare against a tracked baseline, not a midpoint. It primes from the first
    sample rather than assuming 2048, adapts on a ~32s time constant, and freezes
    while a neighbour is present --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
    [hall_presence.h, main.cpp]
2026-08-11 Detect the neighbour sensor at boot instead of selecting it at build time (#26)
    * Sensor-mode discriminator logic, tested natively
    Stage 1 is a mask test and stage 2 a byte comparison, both pure, so the
    decisions that matter are checked off-hardware. The 2-of-6 invariant is
    asserted for all 15 masks rather than the one the bench happened to catch.
    readEEprom's return value is not an input to stage 2: an empty connector
    returns success for every read, so only the bytes carry information.
    * Fix C++14 compatibility: use static constexpr instead of inline constexpr
    inline variables are a C++17 feature. The native test environment builds
    with -std=c++14, so inline constexpr triggered compiler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
    [main.cpp, sensor_mode.h]
2026-08-11 Show the build timestamp on a power-on, before the sleep check-in (#27)
    setup() built the DisplayManager after handleWakeUp(), so a power cycle that
    found a retained auto_sleep flag re-entered deep sleep having painted nothing.
    Correct sleep behaviour, indistinguishable from dead hardware: a stale
    cube/1/auto_sleep read as bad firmware for a good while on 2026-08-11.
    Gated on esp_reset_reason(), not is_first_boot alone: the latter covers brownout,
    watchdog and panic resets too, and lighting the panel for those would spend the
    battery runWakeCheckIn() re-reads the flag to protect. A timer-wake check-in
    still holds the panel off and keeps its current saving. The rail is already up by
    here and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
    [main.cpp]
2026-08-13 Publish the presence reading so a magnet swap can be measured (#28)
    * Publish the presence reading so a magnet swap can be measured
    The ID sensors are digital, so cube/N/hall_debug says whether a magnet
    tripped one but nothing exposes how much margin the analog presence
    reading has over HALL_PRESENCE_ON_DELTA. Tuning that threshold, or
    judging whether a weaker presence magnet still clears it, was blind.
    Publishes delta, baseline and the raw filtered reading alongside the
    thresholds they are compared against, so one retained message answers
    "is this magnet strong enough" without cross-referencing the source.
    Rate-limited to 2 Hz and gated on a delta move of 8 counts or an
    active flip: the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
    [hall_presence.h, main.cpp]
2026-08-13 Seed the presence baseline from NVS on a cold boot (#29)
    * Seed the presence baseline from NVS on a cold boot
    RTC memory carries the baseline across every wake but is garbage after
    a power cycle, which is the one case where a cube is likely to be
    sitting docked on a shelf: it primes its baseline onto its neighbour's
    magnet and reports no neighbour. Measured on slot 1 -- a power cycle
    while docked came back with base 1925 against a true 1771.
    NVS survives the power cycle. It cannot hold a continuously changing
    value, though, so this writes only when the baseline has moved more
    than 16 counts from what is stored, which given how slowly it drifts is
    a handful of writes a day rather than the ~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
    [cube_slot_store.cpp, cube_slot_store.h, hall_presence.h, main.cpp]
2026-08-13 Stop hall_presence streaming at the rate cap forever (#31)
    The change gate was 8 counts against an ADC noise band of roughly 36 --
    measured on slot 1 both undocked (-13..+35) and docked (135..171) -- so
    it was always open and the topic published at its 2Hz cap for as long
    as a cube was powered. Measured on a settled docked cube: 85 messages
    in 43s, none of them reporting anything that had changed. Six cubes in
    a game is ~12 messages a second of diagnostics that nobody reads, on
    the firmware whose optimisation history is mostly about removing
    exactly this.
    Raises the gate past the noise so the topic reports movement rather
    than jitter. Asserts and releases publish regardless of size, so the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
    [main.cpp]
2026-08-13 Publish a smoothed 0-100 proximity for animation (#30)
    * Publish a smoothed 0-100 proximity for animation
    cube/N/proximity rises with closeness -- 0 is nothing in range, 100 is
    a docked neighbour -- so brightness, size or speed can use it directly
    without inverting anything or knowing about the out-of-range sentinel.
    The curve comes from the distance conversion rather than delta, because
    field falls off as the cube of distance and an animation driven by
    delta would spend most of its travel in the last few millimetres. Its
    endpoints are stated in the delta counts they were measured in: the ADC
    noise floor at the far end, beyond which nothing is distinguishable
    from an idle sensor, and a doc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
    [hall_presence.h, main.cpp]
2026-08-13 Stop rewriting the live proximity on every reconnect (#33)
    subscribeSlotTopics() runs again on each MQTT reconnect with the slot
    unchanged, where clearing the retained proximity deletes the cube's own
    current value and writes it straight back.
    The publish cache is still invalidated, and has to be: the broker runs
    with persistence false, so a reconnect may be to a broker that has
    forgotten every retained record, and publish-on-change alone would
    leave the topic empty until the neighbour physically moved.
    Claude-Session: https://claude.ai/code/session_01AERDgB64N1HaKJX7VxpBQp
    [main.cpp]
2026-08-13 Correct the stage-1 invariant: the reading is not 2-of-6 (#34)
    The comment claimed at most two sensors are ever active and at least
    two of P1-P4 stay high whatever is docked, and the safety argument for
    probing SPI rested on it. The encoding is 2-of-6; the reading is not.
    Crosstalk adds sensors, and on slot 1 a stacked presence magnet 32.3mm
    from U1, U2, U4 and U5 drove all four active while U3 held a real ID
    magnet -- every ID line low, which is exactly what a floating PN5180
    reads. A cube booted docked in that state detects as a reader and stage
    2 drives SPI into the hall board's open-drain outputs.
    Reading harder cannot fix it: floating-with-pulldown and driven-low are
    the same level, an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
    [sensor_mode.h]
2026-08-14 Point slot 2's backup board at its replacement ESP32 (#35)
    5C:01:3B:65:46:2C could associate and hold keep-alives but collapsed
    under sustained transmission: 93% packet loss and ~1900ms round trips
    against 0-7% and 20-35ms from three other cubes measured back to back,
    and six OTA attempts that never got past the address probe. A battery
    swap changed nothing, which ruled out the cell.
    The replacement inherits the row wholesale -- compiled slot 2, RGB
    order and octet 42 -- because only the ESP32 moved. The cube keeps its
    body, its NFC sticker and therefore its address on the network.
    Claude-Session: https://claude.ai/code/session_01AERDgB64N1HaKJX7VxpBQp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
    [cube_utilities.cpp]
2026-08-14 Replace slot 2's backup ESP32 with a working 38-pin module (#36)
    The 30-pin briefly recorded here was never installed: this cube has a
    documented history of 30-pin modules failing to drive HUB75, so it was
    abandoned for a 38-pin before it went in the enclosure.
    Records the swap in the hardware log, including three things that cost
    time and are not obvious from the code: the pin count is documentation
    rather than configuration, a chip returning zero serial bytes is broken
    upstream of bootloader mode, and a new MAC needs a retained null
    assignment before first boot or it claims its compiled slot from
    whatever board is holding it.
    Claude-Session: https://claude.ai/code/session_01AERDgB64N1Ha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
    [cube_utilities.cpp]
2026-08-14 Stop the fleet flash waiting on cubes that are not there (#37)
    "all" walked a fixed list of twelve slots and gave each one a full wake
    window before it could fail, so a bench holding half the fleet spent
    minutes rediscovering that the other half was unpowered. Measured: six
    minutes of dead waiting on a run where six slots had no board.
    Wakes the fleet once, waits once, then asks each slot whether anything
    answers -- a probe costs 3s against the 60s a missed wake window costs.
    The same run now takes 2m29s end to end.
    The skipped slots are named rather than dropped, so a shortened run
    cannot read as a whole-fleet one.
    An assignment record cannot stand in for the probe: every slot has one
    wh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
2026-08-20 Land the tile when the letter lands, not before
    The cube half of the same change in cubes/. `Ease::BounceOut` reaches 1.0 at
    4/11 of its duration and rebounds for the rest, so the glyphs traded dominance
    well before the server actually changed the tile -- the panel read as its new
    letter while the rack still held the old one.
    Re-proportion the curve so the travel segment lasts `rise_ms` instead of the
    library's fixed 4/11. The tail is REMAPPED rather than rewritten: `u` carries
    [rise, 1] back onto the stock [1/2.75, 1], so the three rebounds keep their
    shape and their relative depths and merely occupy whatever time is left.
    Continuous at the seam by construction -- at t == rise, u == 1/2.75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
    [main.cpp]
2026-09-11 Add the player-1 cubes to the board version table
    flash_cubes.sh resolves a cube's build environment by looking its MAC up in
    config/cube_board_versions.txt, and refuses to flash a MAC it cannot find.
    Every slot 11-16 MAC was absent, so an OTA flash of any player-1 cube failed
    at the lookup:
    Detected MAC: EC:E3:34:79:9D:2C
    MAC EC:E3:34:79:9D:2C not found in .../config/cube_board_versions.txt
    The workaround was to pass the environment positionally (`flash_cubes.sh 12
    v6`), which skips the lookup entirely. These five rows make the default path
    work instead.
    All are v6, matching every other board in the table and the "30-pin" note on
    each entry in CUBE_MAC_TABLE. Slot 11 is deliberat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
2026-09-12 Show the cube number on the boot screen, not just the IP octet
    The boot screen printed only WiFi.localIP()[3], so it named a cube by an
    address while the admin page names it by slot. For a cube sitting in the slot
    its octet was chosen for the two are a fixed offset apart and the difference
    never shows. For a spare they are unrelated: the one at .47 runs as slot 1,
    so its screen read "47" while the admin page called it cube 1, with nothing
    on either to connect them.
    The line now reads "c1 ip47" -- both names for the same cube, which is the
    pairing that cannot be derived from either number alone.
    Both inputs are already resolved where the line is drawn: loadStoredSlot()
    runs earlier in setup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
    [cube_utilities.cpp, cube_utilities.h, main.cpp]
2026-09-15 Report NFC read cost split by protocol outcome (#45)
    * Report NFC read cost split by protocol outcome
    `nfc=` in the diag string is a section average: total read time divided by
    MAIN LOOP ITERATIONS, and most iterations dequeue no NFC result, so it is
    diluted by an unknown factor. Read as a per-read figure it says NFC reads cost
    ~0.12 ms. The duty cycle says otherwise.
    Taking `nfc` x `samples` against `loop` x `samples` from two cubes on the rig:
    .41 138.1 s of NFC read in a 286.4 s window 48.2% of wall clock
    .45 108.3 s of NFC read in a 287.1 s window 37.7% of wall clock
    At ISO15693 timings that can only be tens of milliseconds per read. A 1 ms
    read would require 482 reads/se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
2026-09-16 Commission the spare into slot 15 and retire its old chip (#46)
    Slot 15 has been silent at 192.168.8.35 with nothing answering ARP, so
    the board that held it is out of service. The spare takes the slot and
    the old chip takes the spare row, which keeps the table at twenty rows
    with every octet still unique.
    The slot keeps octet 35 rather than carrying the spare's 47 across, so
    the fleet flash resolves it at the address its slot implies and needs no
    retained assignment record to find it. RGB order stays with the slot: the
    panel does not move when the chip does.
    Claude-Session: https://claude.ai/code/session_01V14XzUvWkLJXD6raVhN4ba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
    [chip_inventory.csv]
2026-09-16 Replace slot 12's ESP32 with a new chip (#43)
    The old chip (EC:E3:34:79:9D:2C) gives way to a fresh 20:50:0D module.
    Swap the MAC in the production table and the flash-version lookup so
    wired and OTA tooling both resolve the new chip to slot 12 at v6.
    [cube_utilities.cpp]
2026-09-16 Replace slot 13's ESP32 with a new chip (#44)
    The old chip (04:83:08:59:6E:74) gives way to a fresh 20:50:0D module.
    wired and OTA tooling both resolve the new chip to slot 13 at v6.
    The inventory follows the same swap, the replaced chip moving to a spare
    row rather than being dropped. Its board version and panel wiring stay
    with the slot, since neither moves when the chip does.
    Claude-Session: https://claude.ai/code/session_01V14XzUvWkLJXD6raVhN4ba
    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
    [chip_inventory.csv]
2026-09-16 Commission slot 12's former chip into the empty slot 11 (#49)
    Slot 11's row has been a placeholder since its chip moved to cube 4, and
    nothing has answered at 192.168.8.31. The chip this stack just displaced
    from slot 12 fills it, taking octet 31 so the slot resolves at the
    address it implies.
    Its board version entry comes back, having been removed with the slot 12
    row: the version tracks the PCB, and the board is still the same one.
    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
    [chip_inventory.csv]
2026-09-16 Fix replace_chip.sh: it could not edit any row or find any board version (#48)
    The script has been non-functional end to end since 27c3992 keyed the
    MAC table by cube id. Three faults, each silent:
    Its sed matched a "// <cube number>" comment, but that refactor made the
    comments "// 30-pin", so the substitution matched nothing and left the
    table untouched — and a sed that matches nothing still exits 0, so the
    run printed an unchanged "Updated entry" and carried on. The row is now
    matched on the cube id and IP octet fields, and the edit is read back
    out of the file before the script claims it applied.
    The octet is part of the match because cube ids 1-6 each appear twice,
    once for the prim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
2026-09-16 Record the chip slot 5 actually runs (#47)
    The inventory still named the chip that slot 5 ran before its
    replacement, so it disagreed with both the compiled table and the board
    version file, which have carried 04:83:08:59:76:98 for some time. The
    replaced chip moves to a spare row rather than being dropped.
    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
    [chip_inventory.csv]
2026-09-16 Add flash_cube_wired.sh: scripted USB flash workflow (#39)
    * Add flash_cube_wired.sh: USB flash workflow as a script
    The fleet script resolves cubes over the network, so a board plugged
    into the Mac by USB had no scripted path — the flash workflow (MAC
    lookup in the board table -> environment, native tests, compile, flash,
    boot verification) was being done by hand, which is where the wrong
    environment gets picked. The script reads the MAC off the wire, refuses
    unknown boards, and runs the same steps in order every time.
    * Verify the booted cube id, and tell one board from two device nodes
    Review found two ways this scri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
2026-09-16 Key the sleep flag to the MAC alone (#50)
    A cube read one of two retained auto_sleep flags: the slot-scoped one when
    it held a slot, the MAC-scoped one when it did not. tools/wake.sh cleared
    only the slot-scoped topic, so a board with no stored slot -- a spare, or
    one whose NVS had been cleared -- watched a flag that nothing ever cleared
    and could not be woken at all.
    The MAC is the identity a board always has, so that is the one the flag
    hangs off now. The fallback branch, the has_slot_topic parameter and the
    two-field SleepFlags all go with it, and wake.sh resolves a cube number to
    a MAC instead of publishing to a slot topic. It asks the retained
    assignments first, since they outrank the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
    [cube_utilities.cpp, cube_utilities.h, main.cpp]
2026-09-17 Put 20:50:0D:30:95:48 into slot 13 (#51)
    The board went into slot 13's cube, so it takes that row and its octet,
    33. The chip it displaced keeps an entry as a spare on the first free
    octet rather than being dropped.
    RGB order stays with the slot: the panel does not move when the chip
    does.
    EXPECTED_ROWS follows the table from twenty rows to twenty-one. The check
    exists to catch an accidental deletion, so it has to be told about a
    deliberate addition.
    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
    [chip_inventory.csv]
2026-09-17 Correct what CLAUDE.md says about sleeping and waking (#52)
    There is no hourly battery-maintenance wake. esp_sleep_enable_timer_wakeup()
    is called once, with sleep_interval_s, and the bullet below already describes
    what actually happens, so the claim is removed rather than reworded.
    How a cube decides to go back to sleep was not written down at all, and it
    is not guessable from the topic name: the flag hangs off the MAC, so a
    publish to a slot-numbered topic is ignored without complaint. That cost two
    failed wake attempts before anyone read the firmware.
    The tools list gains flash_cube_wired.sh and replace_chip.sh, which it had
    been enumerating around.
    Claude-Session: https://claude.ai/c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
2026-09-17 Give each slot exactly one board in the MAC table (#53)
    Cube ids 1-6 each appeared twice, once for a "primary" board and once for
    a "backup" that could stand in for it. The roster has long since decided
    which board holds a slot, and it says the primaries hold none: all six
    carry a retained slot:null and not one has ever published presence. The
    fielded fleet is the boards the table called backups.
    So the ids follow the roster. A board keeps an id only where the roster
    says it holds that slot, and the rest carry CUBE_ID_NONE -- which is what
    their assignment records have said all along. Slot 3 moves onto the board
    actually serving it rather than the one whose row happened to claim the
    id.
    va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
2026-09-17 Delete the compiled NFC tag table (#55)
    The server resolves a tag to a slot now, so lookupCubeNumberByTag had no
    caller outside its own tests -- and those tests asserted a mapping the
    hardware has since contradicted: tag C1A81366080104E0 as cube 11, when
    the enclosure carrying it holds slot 13. Anyone grepping a tag id hit
    that table first and got the wrong slot from it.
    The table, its lookup and its twelve tests go, along with the native
    build filter entry and the include in main.cpp, which was the only thing
    still pulling the header in.
    The hall-decode comment loses its pointer to the file but keeps what it
    was there for: ids are 1-6 and 11-16.
    The cube pool design is updated where it d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
    [main.cpp]
2026-09-17 Stop compiling a slot into any board (#56)
    The roster decides which slot a board plays, and has since rollout step
    3. The table went on carrying a slot as well, so the two could disagree
    -- and did: a board that had moved kept claiming the slot its old row
    named, which is how one cube ended up impersonating another that was
    already running.
    Every production row now carries CUBE_ID_NONE, leaving the table what it
    alone knows: the octet a MAC answers on and how its panel is wired. A
    board with no assignment stays unassigned instead of adopting a slot.
    Nothing fielded changes. The stored slot in NVS is preferred over the
    compiled one and survives a reboot without the broker, so only a board
    t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
    [cube_utilities.cpp, cube_utilities.h]
2026-09-18 Run the firmware checks on every pull request (#60)
    * Run the firmware checks on every pull request
    This repo had no CI at all -- no .github directory -- so the validator, the
    native tests and the hardware compiles only ever ran when someone remembered
    to run them. Every one of them is a host-side check that needs no cube, so
    there is nothing to stop a machine doing it.
    Gates on `pull_request` rather than `push`, because that builds the merge of
    head into base. The MAC table is the case that makes it matter: nearly every
    hardware change edits that one file, and validate_mac_table.py enforces
    uniqueness across rows, so two branches can each add a board, each pass alone,
    and collide the mome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
2026-09-18 Stop publishing the slot-scoped NFC topic (#57)
    Nothing reads cube/nfc/{id}. The game subscribes to cube/device/+/nfc,
    which carries the same tag with the sender's MAC and boot_id, and to
    cube/right/#; the only other match is a metrics counter that globs
    "/nfc/". The code already called this one debug-only.
    It is also the hazard the cube pool design names: retained and
    slot-scoped, so an observation from a board that has since been replaced
    gets read as the new holder's. Three retained publishes per cube go with
    it, one of them on every read.
    last_neighbor_id stays. It is what the game writes through game/nfc/{id}
    and what the hall path consults to force a re-announce, so it now tracks
    the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
    [main.cpp]
2026-09-18 Choose the neighbour sensor when flashing, not at boot (#58)
    A board carries one neighbour sensor for as long as it is that board, so
    probing the connector at every power-up asked a question whose answer was
    already known -- and asking it was not free. Stage 2 drives NSS, RST,
    MOSI and SCK, which are open-drain sensor outputs on a hall board, and
    stage 1 cannot always tell the two apart: a presence magnet close enough
    to four ID sensors pulls every line stage 1 can test low, which reads
    exactly like a floating PN5180. The comment recording that measurement
    says it is unfixable by reading harder, and the guards were magnetic and
    procedural.
    The hall board supplies the ID sensors and the pres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
2026-09-18 Hold the presence baseline while a neighbour is there (#59)
    A cube trips its ID sensors well before the presence signal reaches the
    latch threshold, and the baseline was free to adapt through that whole
    band. Held at a middling distance it walked up to the magnet over about
    half a minute, the reading decayed to nothing, and pulling the neighbour
    away left the baseline above true idle -- a negative delta. Seen on cube
    c, where the bar tracked distance and then went dead.
    The ID sensors are digital and independent of the analog reading, so they
    can say a neighbour is there while the analog signal is still below the
    trip point. update() now takes the mask and freezes on it, the same test
    the s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
2026-09-18 Flash player 1 with the analog hall firmware (#62)
    All six player-1 boards carry the six GH1230KSW ID sensors and the DRV5055A4
    presence pigtail on GPIO36, so the env each gets at deploy has to say so.
    flash_cubes.sh uses this value directly as the PlatformIO environment name, so
    a stale 'v6' here silently flashes NFC firmware onto hall hardware: the ID pins
    read nothing and the cube reports no neighbours, with no error anywhere.
    This is the content of #61, which merged into its stacked base after that
    branch had already been squashed into main, so it never reached main.
    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
2026-09-18 Report the hall sensor state in the diag response (#63)
    A cube with a neighbour beside it that reports nothing gives the same reading
    whether a magnet is missing, a sensor sees nothing, or the presence baseline
    never primed -- proximity 0 and an empty right/{id}. Those need different
    fixes, and diagnosing slot 11 stalled three times on not being able to tell
    them apart from outside. cube/{id}/hall_debug already shows the ID mask, so
    what was missing is the analog presence side.
    Adds hall_mask, hall_raw, hall_base, hall_delta, hall_active and hall_primed
    to the diag UDP response. hall_primed is the one that carries new information:
    an unprimed tracker is silent by design, which is indistingu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
    [hall_presence.h, main.cpp]
2026-09-18 Make a bad presence baseline both unlikely and recoverable (#66)
    * Make a bad presence baseline both unlikely and recoverable
    Slot 16 cold-booted, sampled 1702 while the sensor output was still rising to
    its ~1850 idle, and primed there. The 148-count difference latched active_, and
    the freeze then protected the very baseline that would have cleared it. The bad
    value had already reached NVS in the moment between priming and latching --
    shouldSavePresenceBaseline() gates on id_mask and active_, and neither was set
    yet -- so a power cycle restored it and the cube was stuck reporting a
    neighbour that was not there.
    Two halves of the same fault.
    Prevention: the reference now comes from the se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
    [hall_presence.h, main.cpp]
2026-09-18 Point the magnet table at the magnets that are fitted (#65)
    Prevention: the reference now comes from the settled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
    [main.cpp]
2026-09-19 Tune presence detection to the boards that exist (#67)
    * Tune presence detection to the boards that exist
    95 counts sat above two of the five docked pairs. Those reported a neighbour
    anyway, because hysteresis had latched them while being pushed together and
    OFF_DELTA of 48 was below their steady reading -- so the chain looked healthy
    while a fresh docking would have missed.
    The reason 95 could not simply come down is that idle excursions reached 34
    counts against a weakest docking of 63: no threshold separates those. The fast
    filter was averaging 8 samples, which is not enough smoothing for boards with no
    ground plane. 32 samples takes the idle floor to 11 for about 32ms of added
    latency,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
    [main.cpp]
2026-09-19 Let the four ID pins that can fail safe do so (#68)
    The GH1230KSW outputs are open-drain against a 10k pull-up on the daughterboard,
    so a line whose pull-up path opens floats -- and it floats LOW, which reads as a
    magnet that is not there. Slot 16 lost P6 to a bad solder joint exactly that way
    and sat reporting a mask of 0x30 with nothing beside it, which blocked its
    presence baseline from ever priming.
    pinMode was plain INPUT on all six, so none of them had a fallback. GPIO 34 and
    35 are input-only with no internal pull-up and cannot be given one, but the other
    four can: an open pull-up path then reads HIGH, which is "no magnet". Costs
    nothing and needs no hardware change.
    P5 and P6 still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
    [main.cpp]
2026-09-19 Hold a chattering NFC reconnect for confirmation (#69)
    * Hold a chattering NFC reconnect for confirmation, hall untouched
    Two cubes right at the edge of NFC range flip present/absent rapidly --
    measured on hardware at up to ~10 flips/sec (51 flips in 15s via
    cube/device/{MAC}/nfc). Every flip was a real, instantly-published
    transition, so the server's neighbor handling (beep + border flash +
    word re-evaluation, all one path through _apply_neighbor) fired on
    every one of them.
    Almost always the player meant the cubes to be apart, not together, so
    bias the resolution toward apart instead of adding latency to every
    connect:
    - Disconnects are never held back -- the safe default is always inst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
    [cube_utilities.cpp, cube_utilities.h, main.cpp]
2026-09-19 Preview Hall neighbor candidates on both cubes (#71)
    * Preview Hall neighbor candidates on both cubes
    * Debounce Hall preview candidates
2026-09-19 Stop Hall border preview after docking (#72)
2026-09-20 Pulse Hall preview edges in opposite directions (#74)
    * Pulse Hall preview edges in opposite directions
    * Update Hall ID magnet mappings
2026-09-20 Raise Hall presence threshold for marginal preview
2026-09-20 Fix marginal border preview rendering
    [main.cpp]
2026-09-20 Delete the rgbmatrix panel scripts
    tools/test_cube.py and tools/test_matrix.py drive a chained 128x64
    rgbmatrix panel through the Pi's rgbmatrix library. This project's cubes
    are 64x64 HUB75 panels driven by the ESP32's I2S DMA, so neither script
    can run against any hardware here, and nothing in the repo invokes them.
    Claude-Session: https://claude.ai/code/session_01Y2MtREP9zHKyDbNgUigw5d
2026-09-20 Delete the three bench jig sub-projects
    src_hall_test, test_gpio and test_pn5180 are standalone PlatformIO
    projects that build only if you cd into them. Nothing in platformio.ini,
    CI, or tools/ references any of them, and all three were last touched in
    March 2026.
    src_hall_test polls GPIO 23 and prints NEAR or FAR; hall_presence.h and
    the ID pin scan in main.cpp cover that ground against real hardware.
    test_gpio checks GPIO 35 for damage and test_pn5180 exercises a PN5180
    module on a v1 board.
    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
    [main.cpp, test_gpio.ino, test_pn5180.ino]
2026-09-20 Drop the unused Easing dependency and a dead include path
    Easing is not used: the only mention in src/ is a comment naming
    Ease::BounceOut as the curve DisplayManager::bounceOut is modelled on,
    and that curve is hand-rolled so the travel segment can last rise_ms.
    ../cube-esp32-server/include does not exist anywhere on disk. The flag
    was repeated in all four hardware environments; the compiler silently
    ignores a missing -I path, so nothing ever failed.
    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
2026-09-20 Stop subscribing to topics nothing publishes
    Eleven subscriptions had no publisher in any of the four subrepos: the
    individual border setters that cube/N/border replaced, cube/string,
    cube/N/font_size, and game/nfc/N. Each cost a subscription on every MQTT
    reconnect and a handler that could not be reached.
    The four border colour members stay -- handleConsolidatedBorderCommand
    and the preview animation own them now. Only the per-side setters go.
    vline_height had one writer, /border_vline_height, so it was always
    PANEL_RES; drawBorders now says so directly. display_string and
    font_size had no reader at all once their setters were gone.
    MQTT_TOPIC_PREFIX_GAME and MQTT_TOPIC_PREFIX_NFC existe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
    [cube_utilities.cpp, cube_utilities.h, main.cpp]
2026-09-20 Delete globals and includes nothing reads
    Twenty declarations with no reader. Most are residue from the
    cube_messages.h protocol that main.cpp opens by stubbing out, and from
    an NFC publish path that the worker task replaced.
    Three had a writer but no reader, which is the case a compiler will not
    warn about: sleep_start_time and last_letter_recv_time were assigned
    every sleep and every letter, and SectionTiming::total_us was zeroed on
    every diag read. Nothing ever looked at any of them.
    NFCID_LENGTH survives the loss of the stub block: cube_utilities.h,
    included on the next line, defines it identically.
    The watchdog stays. esp_task_wdt_init is commented out, so the
    esp_task_wdt_reset in l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
    [main.cpp]
2026-09-20 Drop the compiled slot from the MAC table
    Every production row carried CUBE_ID_NONE and validate_mac_table.py
    rejected anything else, so the cube_id column, findCubeId(), the
    CUBE_ID_NONE sentinel and the compiled_cube_id global all resolved to
    the same nothing on every board.
    No behaviour changes. The two places the compiled id reached both
    received 0 and both treated it as absent:
    fallback = stored.slot > 0 ? stored.slot : compiled_cube_id
    gave stored.slot or 0, and applySlot() treats every value <= 0 as NO
    SLOT -- the same answer the stored -1 now gives. formatBootIdentity()
    preferred the stored slot and fell through to a compiled 0, printing
    \"c?\"; with one slot argument it prints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
    [cube_utilities.cpp, cube_utilities.h, main.cpp]
2026-09-20 Delete the digital hall gate on NFC observations
    The gate cannot fire. Since #58 the sensor mode is chosen when the board
    is flashed, and HALL_SENSOR_ENABLED selects SENSOR_MODE_MAGNETS -- which
    never enters the NFC branch. In every build that does enter it the flag
    is undefined, so HAS_HALL_SENSOR is false and the two inputs reduce to
    constants:
    hall_allows_neighbor = !false || ... = true
    hall_says_present = false && ... = false
    Those are exactly the values that let every observation through.
    No board runs this either: config/cube_board_versions.txt has six
    v6_with_hall_analog entries and no v6_with_hall, so the environment goes
    too, with the CI matrix and the replace_chip.sh help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
    [cube_utilities.cpp, cube_utilities.h, main.cpp]
2026-09-20 Stop publishing the raw hall ADC
    cube/N/hall_analog has no consumer in any subrepo, and it published a
    raw ADC reading on every change, retained, at up to 20 Hz per cube. The
    same reading is already available twice over with more context: hall_raw
    in the diag response, and raw= inside cube/N/hall_presence, which is
    rate-limited and change-gated as this was not.
    Unlike the other dead code in this sweep, this compiles today on the six
    v6_with_hall_analog boards, so it takes effect only when they are
    reflashed, and their retained records outlive the firmware.
    HALL_SENSOR_PIN was a second name for HALL_PRESENCE_PIN -- both GPIO 36
    -- and its pinMode duplicated the one in setupHallSensors(). Th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
2026-09-20 Delete image mode
    cube/N/imagex has no publisher in any subrepo. It carried a raw
    64x64 RGB565 frame, and supporting it cost two heap buffers of 8 KB
    each, a double-buffer swap through animate() and updateDisplay(), and an
    MQTT packet buffer sized to fit a whole frame.
    The packet buffer is reduced, not removed. PubSubClient defaults to 256
    bytes for the entire packet, and the liveness response -- a 224-byte
    buffer on a ~42-character topic -- reaches about 270 with the fixed
    header, so dropping the call would silently truncate it. 512 clears the
    largest publish with room for a longer nonce.
    Claude-Session: https://claude.ai/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
    [main.cpp]
2026-09-20 Make comments describe the code, not its history
    CLAUDE.md asks that comments refer only to the current state of the
    code. These six described earlier states instead: three signposts to
    code that moved out of main.cpp years ago, two that justify a value by
    naming the PR or the previous value it replaced, and a force-rebuild
    marker left at the end of the file.
    The reasons are kept where they still explain something. The timing
    accumulators are still documented as 64-bit because a 32-bit microsecond
    counter wraps after 4295 s, and the diag buffer is still documented as
    sized for the worst case because snprintf truncates silently. Only the
    appeals to history are gone.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
    [main.cpp]
2026-09-20 Stop publishing proximity, and delete the queue that guarded it
    cube/N/proximity has no subscriber. The game server subscribes to
    sensor_mode, version, device/+/presence, device/+/status and cube/right;
    nothing anywhere reads proximity.
    That makes the retained-delete machinery guard nothing, so it goes
    rather than being simplified: a four-slot pending queue with its own
    eviction policy, the flush pump called on every loop iteration, and the
    rebind dance in subscribeSlotTopics() that decided whether to delete the
    record or merely invalidate the cache. Its comment still claimed only
    one delete was tracked, four lines above the array of four.
    The computed value stays. Two consumers read it lo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
2026-09-20 Sample the hall ID pins once per poll
    The poll read the same six lines twice: once for the debounced mask
    published to hall_debug, then again inside readHallNeighborId() for the
    id decision. Twelve digitalReads per millisecond where six will do.
    The waste was the smaller problem. The two samples were taken
    microseconds apart, so a line caught mid-transition could give the mask
    one value and the id decision another within a single iteration, and the
    debug topic would then describe a sample the decision never saw.
    readHallNeighborId() becomes decodeHallNeighborId(id_mask), taking the
    sample instead of making its own. readHallIdMask() is now the only place
    the pins are read.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
    [main.cpp]
2026-09-20 Keep the two bench jigs
    Per review: test_gpio and test_pn5180 are standalone manual diagnostics,
    so having no caller is not evidence they are unused. GPIO 35 is still a
    live ID pin and a PN5180 module was replaced as recently as April, and
    the jigs carry the wiring tables and procedures for diagnosing exactly
    those failures. Nothing documents that elsewhere.
    Only src_hall_test is deleted now: hall_presence.h and the six-pin ID
    scan supersede its 14-line GPIO 23 poll against real hardware.
    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
    [test_gpio.ino, test_pn5180.ino]
2026-09-20 Build production firmware optimised, not debuggable
    build_type = debug compiles src/ at -Og with -g -ggdb2. The symbols and
    the reduced optimisation exist to make esp32_exception_decoder
    backtraces useful, and that decoder is not used.
    Measured on v6, same source both ways: 39.0 KB of flash and 264 bytes of
    RAM. That is 3 points of the OTA app partition, which matters at 72%
    used because an OTA image has to fit one of two.
    monitor_filters stays. It costs nothing at runtime and still resolves
    function names from the symbol table; only line numbers are lost.
    Claude-Session: https://claude.ai/code/session_01Y2MtREP9zHKyDbNgUi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
2026-09-20 Drop the per-outcome NFC counters from diag
    Nine fields no tool reads. check_cubes.sh, diag_cubes.sh and
    test_cube_diag.py between them parse loop, mqtt, disp, udp, nfc,
    nfc_max, nfc_resets, letter_*, rssi, samples and uptime_ms. None has
    ever read nfc_ok_*, nfc_nocard_* or nfc_err_*.
    They were added to answer one question -- what an NFC read costs, split
    by outcome -- and it was answered: tens of milliseconds, close to
    nfc_max. The answer is kept as a comment on SectionTiming, where it
    warns that nfc= is a per-iteration average rather than a per-read
    figure, which is the number check_cubes.sh thresholds on.
    Also removes the per-read attribution that ran on every dequeued NFC
    result to fee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
2026-09-20 Drop the hall fields from diag
    Six more fields no tool parses. Flagged in the PR rather than done
    quietly: these are the ones that caught slot 16 reporting a neighbour
    that was not there, and they were added for that in #63.
    Separate commit so this half can be reverted on its own.
    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
    [main.cpp]
2026-09-20 Revert "Drop the hall fields from diag"
    This reverts commit 2113c0356d60300a447c46944fa21f30dc62ffe7.
    [main.cpp]
2026-09-20 Threshold NFC health on the slowest read, not the loop average
    check_cubes.sh and test_cube_diag.py both failed a cube when nfc=
    exceeded 5000us. nfc= is total NFC time divided by MAIN LOOP
    ITERATIONS, and most iterations dequeue no NFC result, so it reads
    around 120us while a read actually costs tens of milliseconds. A reader
    stuck at 95ms per read passes that check comfortably.
    nfc_max is a single read, so it means what it says. check_cubes.sh
    already parsed and printed it; it just never tested it.
    60ms clears both plateaus measured across the rig, ~31ms and ~47ms, so a
    healthy cube at the slower plateau still passes.
    nfc= is still displayed. It is a useful duty-cycle signal next to loo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
2026-09-20 Delete the dead watchdog feed
    loop() called esp_task_wdt_reset() every iteration to feed a watchdog
    nothing had subscribed it to. The Arduino core sets loopTaskWDTEnabled =
    false in app_main() and only feeds the task WDT when it is true; nothing
    here calls enableLoopWDT() or esp_task_wdt_add(), and the
    esp_task_wdt_init() beside them has been commented out throughout. The
    call returned ESP_ERR_NOT_FOUND and did nothing.
    Excluded from #83 because the answer was a build-config question I had
    not checked. Checked now, in the core:
    loopTaskWDTEnabled = false;
    ...
    if(loopTaskWDTEnabled){ esp_task_wdt_reset(); }
    Claude-Ses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
2026-09-20 Default the build to v6, the board that exists
    default_envs named v1, so a bare pio run built firmware for a board the
    fleet no longer has: config/cube_board_versions.txt lists 17 boards on
    v6 and 6 on v6_with_hall_analog, and none on v1.
    The v1 environment stays. It still defines the socket-board pin mapping
    and CI still compiles it, so it is the guard against those pins rotting;
    it is just not what an unqualified build should produce.
    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
2026-09-20 Read hall telemetry over UDP, stop retaining it on the broker
    cube/N/hall_debug and cube/N/hall_presence had no subscriber. Both were
    retained for a defensible reason -- publish-on-change goes silent while
    a cube sits still, and retention keeps the last value readable between
    changes -- but the diag response already answers the same question
    without the costs.
    Retention is what made them costly. A retained value outlives the
    firmware that wrote it and looks identical whether it was written a
    second ago or before the cube was last flashed; a UDP query is answered
    by a live cube or it times out. Both topics are also keyed by slot, so
    reassigning a slot strands the record under a name nothing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
    [main.cpp]
2026-09-20 Delete the three flashing tools flash_cubes.sh replaced
    All three predate per-MAC addressing and the version string carrying its
    environment, and each is wrong in a way flash_cubes.sh is not.
    check_firmware_mismatch.sh hardcodes cubes 1, 3 and 6 as v1 boards when
    config/cube_board_versions.txt has no v1 entry at all, so it reports
    mismatches that do not exist. It also compares the diag fw= field, which
    is only ever v1 or v6, so it cannot see a hall board running plain v6
    firmware -- the one mismatch that matters now.
    update.sh points at a firmware path that does not exist, under a build
    directory named for a board rather than an environment.
    update_cubes.py covers cubes 1 to 6 only.
    All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
2026-09-20 Fix the tools that still read a slot out of the MAC table
    The table lost its cube_id column in #84. Four tools still expect it, and
    two of them stopped working when it went.
    flash_cubes.sh matched ZERO rows: its regex counts commas and the row is
    now three fields, not four. resolve_cube_ip() finds the owner of a slot,
    then fails to find that MAC in the table, so any cube is unreachable
    whenever the broker has retained assignments. The 20+N fallback only
    hides it while the broker is down.
    flash_cube_wired.sh scraped cube_id from the boot log, which the
    firmware no longer prints, so it died with "board never printed a
    cube_id" AFTER flashing. It now verifies the static-IP octet, which is
    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
2026-09-20 Skip redundant border redraws
    [main.cpp]
2026-09-20 Read the MAC table in one place, and check it stays readable
    Five tools across two repos parsed src/cube_utilities.cpp with their own
    regex. When #84 removed the cube_id column, three matched nothing:
    flash_cubes.sh could not resolve any address once the broker had
    assignments, flash_cube_wired.sh died after writing the board, and the
    admin page lost a cube. Only validate_mac_table.py was updated, because
    it was the only one with a test and so the only one anyone looked at.
    tools/cube_table.py is now the only reader. It emits
    config/cube_table.json, which is what everything else consumes, and
    flash_cubes.sh, wake.sh and flash_cube_wired.sh ask it rather than
    matching rows themselves. replac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
2026-09-20 Make CLAUDE.md describe the repo as it is
    Nine claims were wrong, and some of them shaped decisions earlier today.
    v6_with_hall is named as an environment and as a board-version value; it
    was removed in #85 and no board ever used it. The default environment is
    v6 now, not v1, and no board is v1 at all.
    "Legacy individual border topics still supported" is what kept ten dead
    subscriptions alive until #82 deleted them. It is a requirement the file
    was asserting, not a description.
    Three code references pointed at line numbers and a file path that have
    moved: cubes_to_game.py became src/hardware/cubes_to_game/. They are
    named rather than numbered now, because numbers rot and these already
    had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
2026-09-20 Clear the DMA back buffer before flipping
    [main.cpp]
2026-09-22 Remove Hall presence debug bar (#73)
2026-09-22 A blank cube goes dark, then drops its panel rail (#107)
    * A blank cube shows no orientation dots
    drawOrientationIndicator() was gated only on the letter animation being
    complete, never on there being a letter. The dots disambiguate rotationally
    symmetric glyphs (N, S, O, X, H, Z), so on a cube cleared to " " they mark
    the orientation of nothing -- two red dots on an otherwise empty panel.
    Most visible on the attract screen, where the three cubes not carrying A,
    B or C are blanked and sat lit anyway. percent_complete also initialises
    to 100, so a cube that had seen no letter since boot was already drawing
    them.
    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
2026-09-25 A repeat of the border target drops the queued one (#108)
    A border change animates for 1000 ms and a target arriving mid-animation
    is queued. A message equal to the animation's current target returned
    early without touching the queue, so under NFC flicker (on/off/on/off at
    70-400 ms) a stale border was queued, the final clear was ignored as a
    repeat, and the queued border was applied when the animation ended. On
    the rig this left cubes 1, 3 and 5 showing end borders the server had
    cleared.
    The target/pending state machine moves into border_transition.h so the
    native tests can drive it; one test replays cube 1's message timings
    from the service log.
    Claude-Session: https://claude.ai/code/s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
2026-09-26 Paint the "!"/"." curtain behind the letter (#109)
    * Paint the "!"/"." curtain behind the letter
    cube/curtain carries R or G plus a row count (0-64); every cube fills
    that many rows from the letter's top in dark red or dark green, drawn
    after the rotation and before the letter. The letter now draws with a
    transparent background so it does not cut a box through the curtain.
    The topic is not retained, so the curtain clears on reconnect.
    The parser is header-only (curtain.h) with native tests: anything
    unparseable clears, oversized counts clamp to the panel.
    Claude-Session: https://claude.ai/code/session_01UssBHveJ3H5T3PhG2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
2026-09-26 flash_cubes.sh retries the address probe (#110)
    * flash_cubes.sh retries the address probe
    An idle cube's radio drops the first ping after a quiet spell, so the
    single 1s probe reported a healthy cube as "on MQTT but its address did
    not answer" -- twice in one bench session on cube 12, which then pinged
    fine. Up to three probes, stopping at the first answer: a live cube
    costs nothing extra, a dead address 3s instead of 1s.
    tools/test_flash_ping.sh stubs ping with one that drops the first probe.
    Claude-Session: https://claude.ai/code/session_01UssBHveJ3H5T3PhG2v9nGP
    * Run the flash probe test in CI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
2026-09-26 Draw the letter in the colour cube/{id}/letter_color names (#111)
    * Draw the letter in the colour cube/{id}/letter_color names
    The server sends each cube its player's rack colour in 2P as retained
    RGB565 ("0xFD20"); empty or anything unparseable restores LETTER_COLOR.
    It replaces only the resting colour -- the green highlight and yellow
    lock still override it. Parser is header-only with native tests.
    * Note why letter_color does not reset the activity timer
    Claude-Session: https://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
    [letter_color.h, main.cpp]
2026-09-30 Believe a change of hall neighbour only once docked strength has settled
    A magnet cube slid against its neighbour shows the ID sensors a pattern
    that belongs to another cube: slid one column, cube 11's P5+P6 magnets
    cross P4+P5, which is cube 4; offset one row, 14 reads as 15. Presence
    stays latched through the slide, so nothing rejected it: at Maker Faire
    94 of 105 out-of-set neighbour IDs were that "4".
    A change from the seated cube to a different one is now believed only at
    HALL_PRESENCE_ON_DELTA, and only after holding for
    HALL_ID_CHANGE_SETTLE_READS (~100 ms). The strength is the tracker's
    filtered delta, which lags a slide by about 32 samples, so the plain
    8-read debounce would still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
2026-10-02 Publish the cell voltage on cubes wired for battery sense
    A cube on the 18650 power board can read its cell through a 1 MΩ/1 MΩ
    divider into GPIO39. The new v6_battery env compiles that in: the cube
    publishes the cell voltage in mV to the retained cube/{id}/battery_mv on
    connect and every 60 s, from 16 averaged samples.
    It is a build flag, like the hall sensor, because only boards with the
    divider fitted have anything on GPIO39; on the rest the pin floats and
    would report noise. config/cube_board_versions.txt maps cube 4's board
    (D4:8A:FC:9F:B0:C0), the only one wired so far, to v6_battery, so
    flash_cubes.sh and flash_cube_wired.sh build it for that board alone.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
    [main.cpp]
2026-10-02 Back off keep-alive check-ins while the broker is unreachable
    With no router, or no Pi, every 20 s check-in holds the radio up for the
    whole 3 s join timeout and fails: about 20 mA average, more than a
    check-in that succeeds. That is exactly the night the rig is packed away.
    Each check-in in a row that cannot reach the broker now doubles the
    next sleep, up to a day (CHECKIN_BACKOFF_CAP_S); one that reaches it
    resets to the configured interval. The counter lives in RTC memory.
    A configured interval already above the cap is left alone. Unplugging
    USB-C cold-boots a cube, which is how a backed-off cube is brought back
    in the morning; the day cap only guarantees one is never lost for good.
    Co-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
    [cube_utilities.cpp, cube_utilities.h, main.cpp]
2026-10-02 A cold boot wakes the cube instead of obeying its sleep flag
    On the battery board, plugging in USB-C disconnects the cube and
    unplugging it cold-boots it, so unplugging from the charger is the
    morning routine, and the way a cube backed off for hours is brought
    back. A cold boot was treated as any other reset and obeyed the
    retained auto_sleep flag, so a cube that slept the night before booted
    and went straight back to sleep.
    A power-on reset (esp_reset_reason() == ESP_RST_POWERON) now wakes the
    cube like the BOOT button. Brownout, watchdog and crash resets still
    read the flag. A jostled battery contact is also a power-on, and costs
    one ten-minute awake spell.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
    [cube_utilities.cpp, cube_utilities.h, main.cpp]
2026-10-02 A cube shows every word of its letter message (#116)
    `cube/{id}/letter` carried one glyph; it now carries the whole payload, so
    "GAME OVER" lands on a cube the same way a letter does -- the same bounce
    curve, the same outgoing-glyph exit, the same is_dirty bookkeeping.
    A message of more than one glyph is laid out by `panel_text.h`: a word per
    line in the built-in font at size 2, centered as a block, descending on the
    animation's percent-complete. One glyph keeps the 78pt letter font and its
    existing placement untouched.
    Red is forced for a multi-word message rather than taken from
    `current_letter_color`, which the lock and the highlight window override --
    both belong to a tile in play, and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
2026-10-03 Retire the v1 socket board: every build drives the GPIO5 panel switch (#117)
    No v1 boards remain. The v6 code paths were behind #ifdef BOARD_V6, so
    only the v1 build skipped the TPS22975 switch on GPIO5; every board in
    the fleet (v6.4.1 and the coming v8.0) routes panel power through it.
    - main.cpp: unifdef -DBOARD_V6, keeping the v6 pins and the panel
    power-up/down and sleep hold unconditionally; drop the v1 pin mapping.
    - platformio.ini: env:v1's base settings become env:v6; the variants
    extend it and no longer need -DBOARD_V6.
    - CI compiles v6, v6_with_hall_analog and v6_battery; the usage strings
    and CLAUDE.md stop offering v1.
    Native tests pass (123/123); all three environments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
    [main.cpp]
2026-10-06 A cube/N/wake command flickers the letter on like a fluorescent tube (#119)
    A letter waking from a sleeping pill snapped from the sleeping colour to
    the resting one. `cube/{id}/wake` now plays the screen rack's flicker on
    the cube from one message: the payload is the sleeping colour, and the
    cube steps between it and its resting colour from a table -- a faint
    starter glow, a strike that fails, another glow, then on with a last dip,
    720ms. The keyframes are the cubes `src/rendering/wake_flicker.py` table.
    One message rather than one per step. The retained `letter_color` still
    carries the awake colour, so a lost wake loses only the flicker. An
    unparseable payload is ignored. Nothing publishes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
    [main.cpp, wake_flicker.h]
2026-10-13 A nearly-flat cube stops staying awake instead of running to the cutoff (#120)
    A cube in play never auto-sleeps: every letter and border resets the
    inactivity timer, so AUTO_SLEEP_TIMEOUT_MS never fires during a game.
    Left on a weak cell that runs full to the DW01A cutoff at ~0.53 A, about
    three hours, and each trip to the cutoff costs the cell some life.
    The cell voltage is already read for cube/{id}/battery_mv, so the gate
    is a latch over that reading: confirmed low at 3.4 V, cleared only above
    3.55 V so an unloaded cell rebounding does not oscillate, and three
    consecutive readings to latch because the cell sags under a lit panel.
    A reading below 2000 mV is a board whose divider was never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
2026-10-14 Turn on battery sensing for the four bodged cubes that lacked it (#121)
    Cubes 2, 3, 5 and 6 have the GP39 divider fitted but were still flashed
    plain v6, so BATTERY_SENSE was absent and the low-battery latch could
    never read the cell. Cube 4 was already on v6_battery; cube 1 has no
    battery and stays on v6.
    None of the five are hall boards, so nothing is lost by the switch --
    there is no env combining BATTERY_SENSE with HALL_SENSOR_ANALOG.
    Claude-Session: https://claude.ai/code/session_011MefRKq7si3YtHCDMVChvf
2026-10-14 A flat cube sleeps until it is picked up instead of waking daily (#122)
    A latched cube had nothing to spend its timer wake on. The gate in
    setup() runs ahead of setupWiFiConnection(), so the wake took no battery
    reading that could clear the latch and reached no broker that could tell
    it anything: it arrived back in enterSleepMode() having done nothing, a
    boot surge poorer, on the cell the latch exists to protect.
    batteryLowCheckInIntervalS() stretched that wake to CHECKIN_BACKOFF_CAP_S
    to make it cheap. Not arming the timer at all is cheaper and loses
    nothing -- Pin 0 and a USB-C cold boot already bring a latched cube back,
    and a cold boot is what clears the latch.
    The cap keeps its other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
2026-10-14 Name the third build environment the board-versions file can hold (#123)
    The file gained v6_battery entries in #121, and the values are PlatformIO
    environments rather than board revisions -- "board version" reads as the
    v6.4.x PCB spin, which the file says nothing about.
    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
2026-10-15 Let a sleeping cube notice its own cell is nearly flat (#125)
    runWakeCheckIn() sleeps without returning, so sampleBatteryRun() in
    setup() is unreachable on a wake that goes back to sleep. A sleeping cube
    therefore never read its cell at all: the latch restored from RTC was the
    only one a timer wake could see, and a cube put away with charge left
    could never set it. It spent the rest down to the DW01A cutoff on
    check-ins twenty seconds apart -- the deep discharge the latch exists to
    prevent, in the one state where nothing was watching.
    Reading ahead of the gate fixes it. With the latch set, a stored cube
    stops arming the timer at all (#122), so the check-ins stop and only the
    deep-sleep floo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
2026-10-15 Wake the fleet before the sweep asks who is awake (#126)
    flash_cubes.sh all reported "No cubes answered; nothing to flash" against
    a fleet that was merely asleep. keep_awake() only publishes cube/N/ping,
    which is QoS 0 and unretained, so a sleeping cube never receives it; what
    it does read, at its next check-in, is the retained auto_sleep flag that
    nothing had cleared. It went back to sleep, failed the is_cube_online
    probe, and was reported absent.
    keep_awake()'s comment said this was fine because "flash_cube still wakes
    it" -- true of the per-cube path, where flash_cube calls wake_cube, but
    the sweep gates flash_cube behind the very probe the un-woken cube just
    failed.
    wake.sh takes no cu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
2026-10-15 Sleep in two bands: quick to revive, then not at all (#127)
    * Sleep in two bands: quick to revive, then not at all
    A cube that dozed off mid-event took up to 20 s to come back, which is a
    long time to stand at the booth waiting for it. Halving that alone would
    have doubled the standby drain, since a check-in costs a boot surge, a
    join and a full dwell, and the 20 s cadence ran forever.
    Idle time now picks the band. Under CHECKIN_GIVE_UP_S the cube checks in
    every 10 s, so it revives while somebody is still waiting; past it
    nothing has touched the cube for an hour and a half, the event is over,
    and it arms no timer at all -- the path the battery latch already used,
    and the button and a USB-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
2026-10-16 Add name entry display geometry and wire parsing (#129)
    Pure helpers for the three-cube high score name entry (lexacube#11 sections 4-5): the section 8 palette, Main/Stream/OK/Arrow geometry, the stream cylinder projection and spotlight curve, and manual JSON parsing for ui_mode, name_entry_state, stream_state and arrow_state.
    No Arduino or panel dependencies, so the native suite pins every number the approved assets fix (22 tests). Unused until the DisplayManager modes land on top.
2026-10-16 Render the high score entry modes (#130)
    DisplayManager gains the UI_MODE_* enum with NAME_ENTRY, LETTER_STREAM, OK_BOX and ARROW_BIDIRECTIONAL rendering, four state handlers plus subscriptions, and a 120ms letter glide so FAST streaming reads continuous while settling on the server-latched center.
    Only ui_mode moves the cube between game and entry rendering; a stray /letter while in entry stashes and shows when GAME_NORMAL returns. Entry modes bypass curtain, borders and the blank power-down, and unparseable payloads are ignored rather than blanking the panel.
2026-10-16 Add env:v8 for the v8.0 board: hall sensor plus battery sense
    The v8.0 board merges the power board onto the cube board: the hall
    board plugs into NEIGHBOR-SENSOR and the cell voltage reaches GPIO39
    through the 1M/1M divider. No environment set both HALL_SENSOR_ANALOG
    and BATTERY_SENSE, so flashing either existing variant would silently
    drop one feature. Board-version values are environment names, so a v8
    cube's MAC maps to `v8` in cube_board_versions.txt with no script change.
    CI compiles v8; usage strings and CLAUDE.md list it. The v8 firmware
    contains both the /battery_mv publisher and the magnets sensor mode
    (checked in the ELF; v6_battery and v6_with_hall_analog each have one).
    Co-Aut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
2026-10-16 v8 cubes report fw=v8 in the diag reply
    fw_board was the literal "v6" once v1 was retired, so a v8 cube would
    answer diag with fw=v6. It is now FW_BOARD, defaulting to "v6" (the v6
    feature variants share the v6 board) and set to "v8" by env:v8.
    Checked in each build's .flash.rodata: v8 holds "v8" and no "v6"
    board name, v6 the reverse.
    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
2026-10-16 Fix entry text wraps on the Main and Stream cubes
    Two defects, one root cause -- drawing past the panel edge for an unclipped
    driver. The 65px HIGH SCORE! header tripped GFX text-wrap, relocating the !
    to x=0 one row down; the drum's edge letters overhung at x0=-1/60 (to -2/62
    mid-glide). Entry draws now disable wrap (the !'s overhanging column is empty
    ink, verified in the font table), stream origins clamp into the panel, and
    every normal-mode draw re-arms wrap.
2026-10-16 Keep the red orientation dots up in entry modes
    All four entry screens show letters, so which-way-is-up still needs
    answering. Drawn last in drawEntryMode so the corners read red over the
    stream rails; unconditional, since entry screens are never blank or
    mid-animation like the normal-mode call sites. Verified on hardware.
2026-10-21 Cube 1 is a v8.0 board: map it to env:v8
    Cube 1's devkit now sits on a v8.0 carrier (lexacube_pcb, power board merged
    on) with a hall-sensor board in NEIGHBOR-SENSOR, so it needs env:v8 -- hall
    ID decode plus battery sense -- not the plain v6 build it was on.
    The old mapping was actively wrong on the bench. Running the NFC build, the
    firmware brings up SPI on the six ID pins, four of which (GPIO 32/17/23/18)
    are output-capable, so they drove push-pull against the hall board's
    open-collector sensors. Connecting a single ID line lit every LED on the
    board. GPIO 34 and 35 are input-only and could never contend, which is why
    the symptom looked stranger than it was.
    env:v8 rather than v6_with_h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
2026-10-21 Say which pull-up each hall board rev actually has
    The comment named 10k as the ID-line pull-up. That was true when it was
    written and is still true for the v2 boards fabbed 2026-07-08, but 2da7f34
    in lexacube_pcb swapped R1-R6 to 4.7k two weeks later because C25804 went
    out of stock at JLCPCB -- so v2.2 and v2.3 boards, including the one on the
    bench now, carry 4.7k. Both revs are in the fleet, which is why this names
    the split rather than replacing one wrong-looking number with another.
    Nothing in the firmware reads the value: HALL_ID_ACTIVE_LEVEL depends only
    on the sense, and the pull-up strength only has to beat the pin leakage.
    Said so explicitly, so the next person comparing the comm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
2026-10-21 Freeze the presence baseline through a wrong-pole excursion
    active_ only latches upwards, so a large negative excursion left it false and
    the baseline adapted down through it. When the reading came back the restored
    value stood on_delta clear of that poisoned reference and latched with no
    neighbour there -- a cube reporting a permanent neighbour, with the latch's own
    baseline freeze holding it there so it could not recover. The bad value also
    reaches NVS in the window between priming and latching, so it survives a
    reboot and only recalibratePresence() can shift it.
    Seen twice, by two different routes into the same excursion:
    cube 13 a hand-waved magnet presented the wrong way round: bas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
2026-10-23 Scale the presence thresholds to the hall board a cube carries
    The fleet runs two hall board revs and they do not carry the same presence
    sensor. v2.2 has a DRV5055A4 at 12.5 mV/mT; v2.3 swapped it for a DRV5055A2 at
    50 mV/mT, four times the ADC counts for the same field. Every presence delta in
    the firmware was measured across slots 11-16 on 2026-09-18, three days before
    that swap landed, so all of them are A4 numbers and none were re-tuned.
    On an A2 board that makes the thresholds four times too sensitive: on_delta 70
    is crossed at roughly a quarter of the intended docking distance, off_delta 15
    further out still, and the proximity bar pins at 100 as soon as a neighbour is
    anywhere near.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
2026-10-25 Give the battery cubes with hall boards an env that keeps battery sense
    Slots 2-5 are v6 carriers with an 18650 and a hall-sensor daughterboard, so
    they need -DHALL_SENSOR_ANALOG and -DBATTERY_SENSE together. No committed env
    offers both for a v6 board: v6_with_hall_analog omits the battery, v6_battery
    omits the hall, and v8 adds FW_BOARD="v8", which these are not.
    The obvious way to write it is wrong, and it was already deployed. An env that
    extends env:v6_battery and sets its own build_flags does not inherit
    -DBATTERY_SENSE, because PlatformIO's `extends` REPLACES build_flags rather
    than appending to it. PlatformIO's own resolved config shows it:
    env:v6_battery ['-DBA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
2026-10-25 Decode the ID magnets the cubes actually have
    The player 0 patterns in hallCubeIdForMask were never measured. The comment said
    so -- "Player 0 has no magnets fitted, so these are a free choice ... fit
    magnets to match, or renumber these to match the magnets, whichever comes
    first" -- and the magnets came first. They are set into a printed carrier with
    fixed slots, so nothing can be nudged to match a table; the table has to match
    Surveyed on the bench 2026-10-25, each cube read by its right-hand neighbour,
    three stable rounds per pattern, every pattern confirmed by at least two
    different readers:
    cube 1 P1+P2 0b000011 cube 4 P4+P5 0b011000
    cube 2 P4+P6 0b101000 cube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
2026-10-26 Stop telling the operator a cube was rebooted when nothing was asked
    flash_cubes.sh printed "Rebooting cube N..." and published to
    cube/<id>/reboot. The firmware never subscribes to that topic -- it subscribes
    to the fleet-wide cube/reboot only, which is why tools/reboot.sh carries the
    note "global topic - firmware doesn't support single-cube reboot". So the
    publish went nowhere and the message described something that had not happened.
    The request was not needed either: espota's upload ends with the cube
    restarting into the new image on its own, which is exactly what the retained
    version check a few lines above relies on. So the fix is to drop both the
    publish and the message rather than t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
2026-10-26 Publish the neighbour edge, not the sensor's point of view
    cube/right/X = Y asserts "Y is immediately to the right of X". That is the
    server's convention, set by scripts/start_game.py, which publishes
    right/<A> = <B> for a word spelled A then B, and admin_server's
    right_neighbor_rows() passes the pair through with no inversion.
    The hall path published the cube it had just sensed on its OWN topic, which is
    only the same statement when the board faces right. Player 0's boards face
    left, so those cubes were asserting the edge backwards. Measured on the bench
    2026-10-25: the physical row 1,3,4,5,6 produced right/3=1, right/4=3,
    right/5=4, right/6=5, which walks out as 6,5,4,3,1. The row is the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
2026-10-26 Send the preview where the neighbour is, not which side to draw
    Both participants in a border preview were sent "E", and the preview renders two
    different shapes from that value on OPPOSITE sides:
    free endpoint drawEndPath caps the end AWAY from the neighbour
    already in a chain drawPreviewSideErasing animates the shared edge,
    which is ON the neighbour's side
    So no single "draw this side" value can serve both topologies. Observed with
    cube 2 docked left of cube 5, both free endpoints: cube 2 animated
    top/bottom/RIGHT where it should have been top/bottom/LEFT, because "E" puts
    drawEndPath's vertical at PANEL_RES_X.
    The payload now carries a FACT -- "my neigh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
2026-10-26 Remove the border preview and the in-between state
    Two states is enough. Presence sensing is deployed on the whole fleet and
    gives clean hysteresis -- on 280 / off 60 at gain 4, with margins measured
    at 2.2x-10.6x across all six plates and two full-row runs producing no
    flapping -- so there is nothing for an intermediate display to paper over.
    The preview was never a flapping mitigation anyway; it was an approach
    hint. What makes it worth deleting rather than keeping is that it was the
    only consumer of sensor-side orientation outside hallEdgeAssertion, and
    that cost two bugs in one day: it animated the wrong walls, and the first
    fix then got the free-end case right and the in-chain case bac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
2026-10-27 Stop guessing the hall gain from the carrier board
    env:v8 forced HALL_DEFAULT_GAIN=4 on the grounds that a v8 carrier ships
    beside a v2.3 hall board (DRV5055A2). Measured on the bench 2026-10-26, that
    is false as built: the only v8 cube carries an A4, and both A2 boards in the
    fleet sit in v6 cubes. The hall board is a daughterboard that swaps
    independently of the carrier, so nothing about the carrier predicts the
    sensor and no build flag can guess it.
    This was not harmless. Cubes 1 and 2 were running gain 4 against A4 boards,
    so their presence thresholds were 280 where 70 is correct -- they needed 4x
    the field to register a neighbour at all. Cube 6 was the mirror case, an A2
    on gain 1, lat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
